fuslab-uofu/SkinCoolingDevice/FinalProduct/AssemblyFiles_Cart/Photos/VacuumOutputValve.JPG

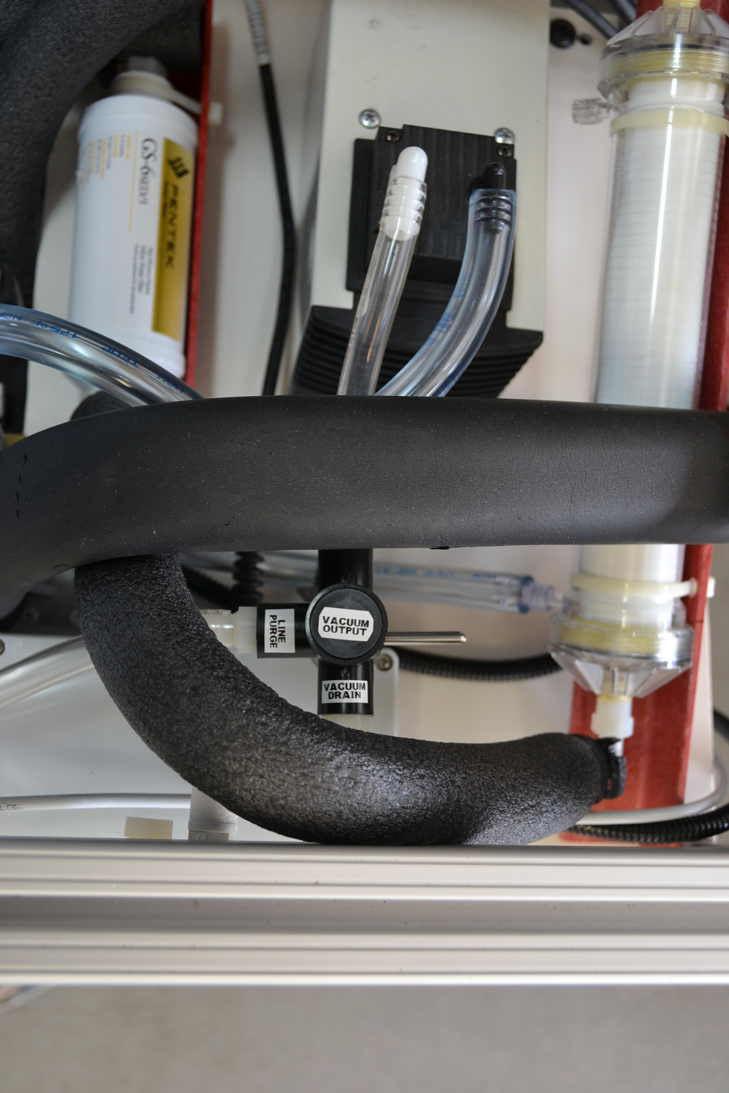
FinalProduct/AssemblyFiles_Cart/Photos/VacuumOutputValve.JPG
