fuslab-uofu/SkinCoolingDevice/FinalProduct/AssemblyFiles_Cart/Photos/Manifold_plate.JPG

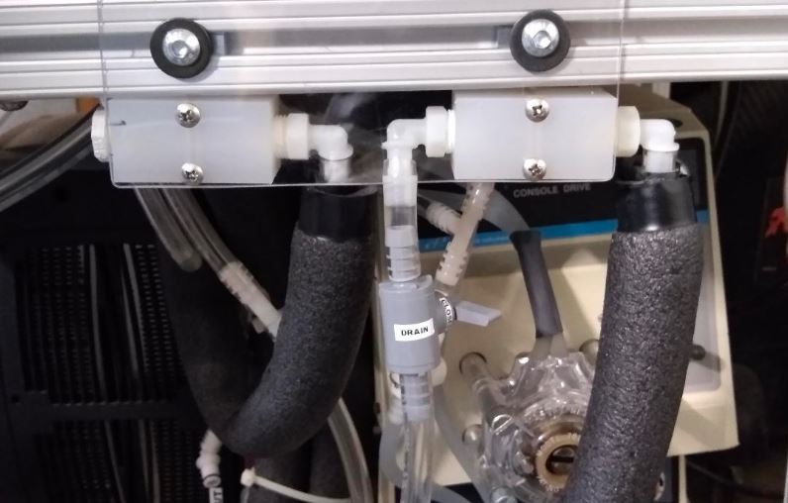
FinalProduct/AssemblyFiles_Cart/Photos/Manifold_plate.JPG
