fuslab-uofu/SkinCoolingDevice/FinalProduct/AssemblyFiles_Cart/SolidworksFiles/2019-12-03_SMB_cap_90_deg.SLDASM

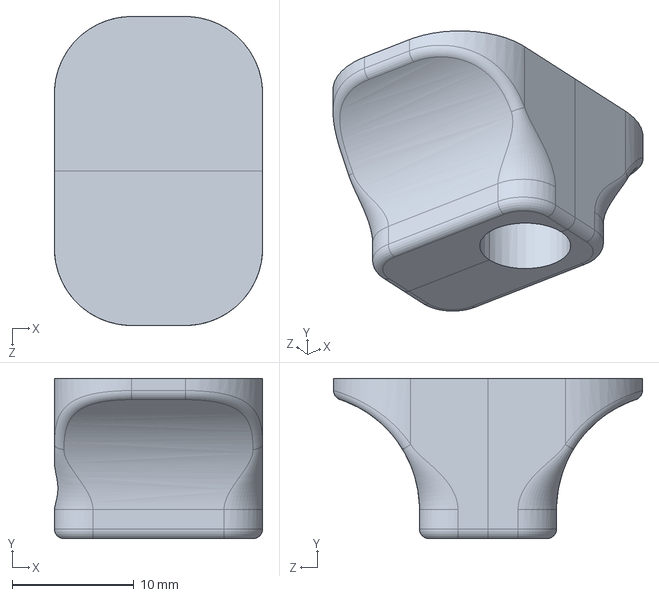
[picture p4: CAD file, 2020-09-22]
FinalProduct/AssemblyFiles_Cart/SolidworksFiles/2019-12-03_SMB_cap_90_deg.SLDASM
17.1 x 13.2 x 25.4 mm
2019-12-03 SMB cap 90 deg x 2
