fuslab-uofu/SkinCoolingDevice/FinalProduct/AssemblyFiles_Cart/SolidworksFiles/2020-01-29_pressure_gauge_mount.STL

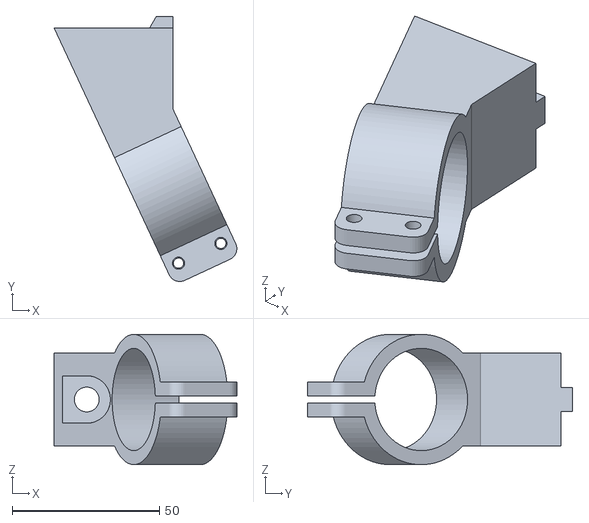
[picture p5: CAD file, 2020-09-22]
FinalProduct/AssemblyFiles_Cart/SolidworksFiles/2020-01-29_pressure_gauge_mount.STL
62.1 x 90.1 x 44.3
