fuslab-uofu/SkinCoolingDevice/FinalProduct/AssemblyFiles_Pad/2020-08-10_Large_pad_-_template.DXF

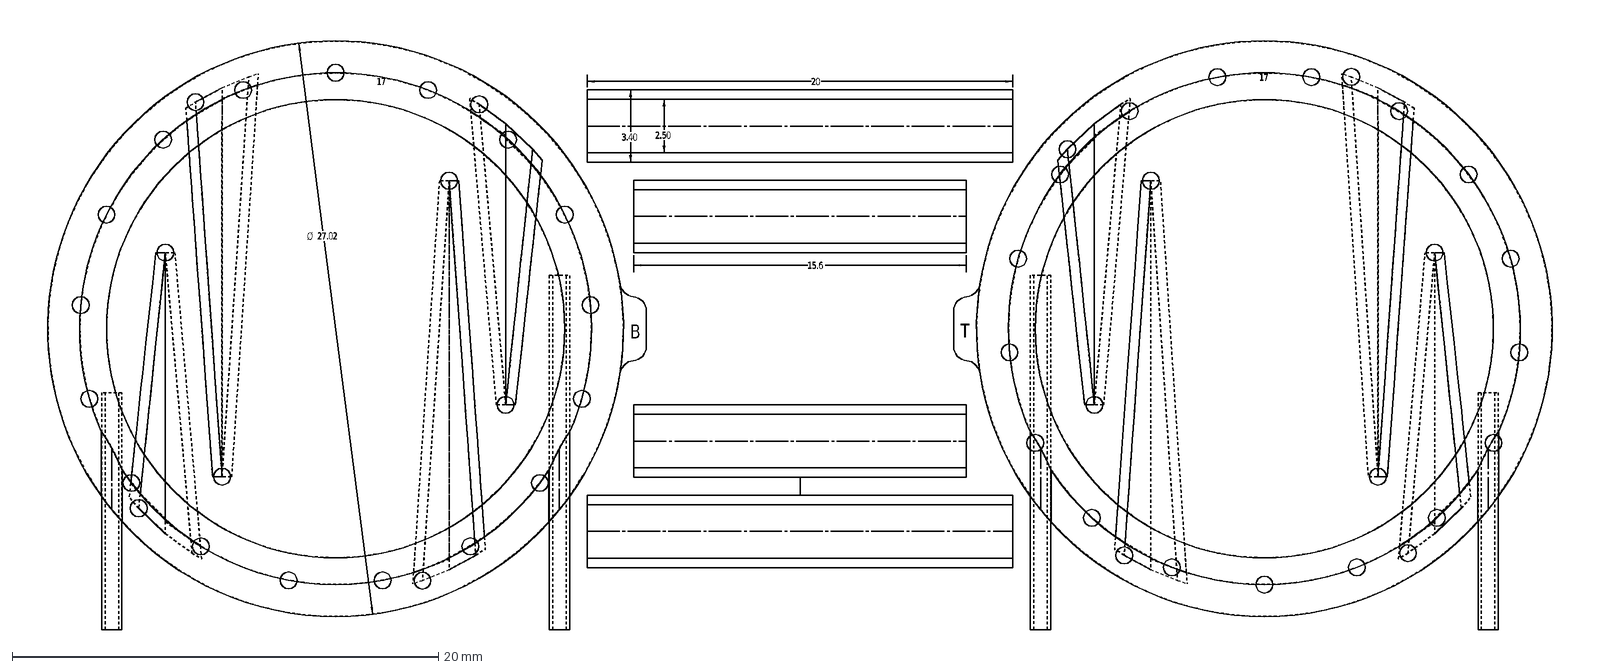
[picture p6: CAD file, 2020-09-25]
FinalProduct/AssemblyFiles_Pad/2020-08-10_Large_pad_-_template.DXF
17
15.6
20
3.40
2.50
Ø
27.02
B
T
