fuslab-uofu/SkinCoolingDevice/FinalProduct/AssemblyFiles_Cart/SolidworksFiles/2020-01-10_SMB_cap_-_straight.STL

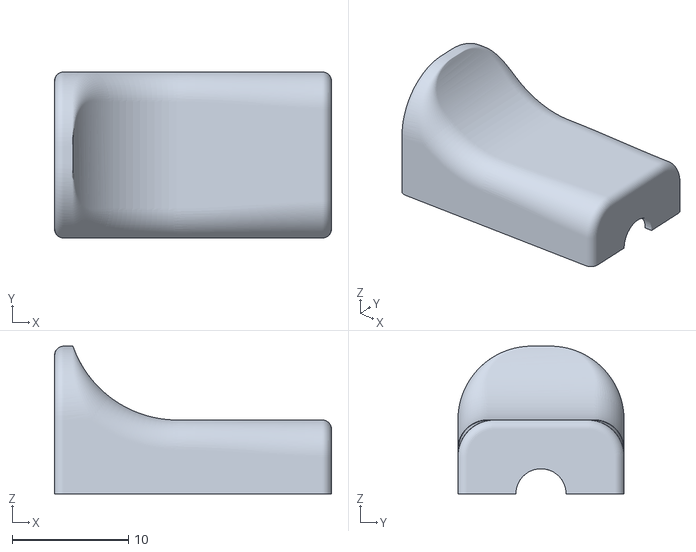
[picture p7: CAD file, 2020-09-22]
FinalProduct/AssemblyFiles_Cart/SolidworksFiles/2020-01-10_SMB_cap_-_straight.STL
23.8 x 14.3 x 12.7
