fuslab-uofu/SkinCoolingDevice/FinalProduct/AssemblyFiles_Pad/2020-08-10_Larger_Pad.SLDPRT

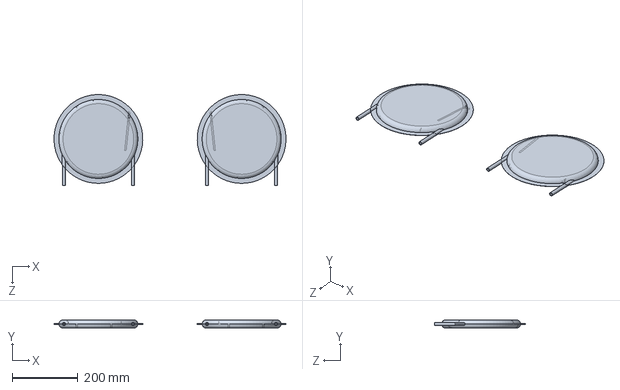
[picture p8: CAD file, 2020-09-25]
FinalProduct/AssemblyFiles_Pad/2020-08-10_Larger_Pad.SLDPRT
705.8 x 25.2 x 276.1 mm
