fuslab-uofu/SkinCoolingDevice/FinalProduct/AssemblyFiles_Cart/SolidworksFiles/2020-01-08_Joined_tubing_clamp.STL

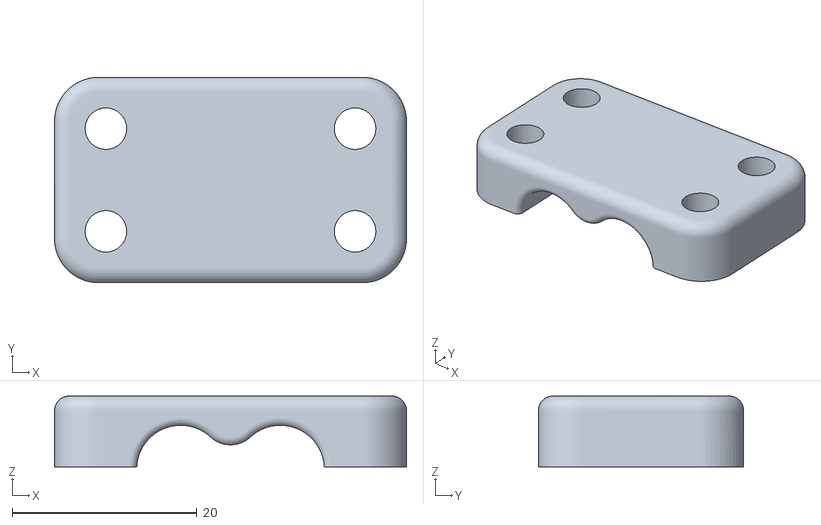
[picture p9: CAD file, 2020-09-22]
FinalProduct/AssemblyFiles_Cart/SolidworksFiles/2020-01-08_Joined_tubing_clamp.STL
38.1 x 22.2 x 7.68
