fuslab-uofu/SkinCoolingDevice/FinalProduct/AssemblyFiles_Cart/SolidworksFiles/2020-02-10_vacuum_tube_and_valve_clamp.STL

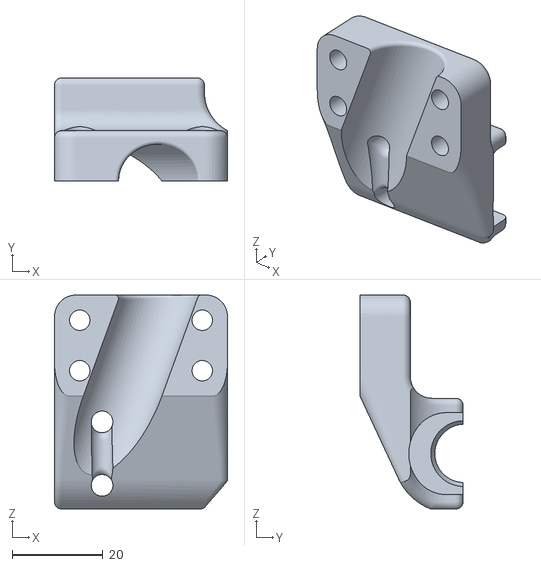
[picture p10: CAD file, 2020-09-22]
FinalProduct/AssemblyFiles_Cart/SolidworksFiles/2020-02-10_vacuum_tube_and_valve_clamp.STL
38.1 x 22.7 x 47.1
