fuslab-uofu/SkinCoolingDevice/FinalProduct/AssemblyFiles_Cart/SolidworksFiles/2020-04-22_Vacuum_muffler_angle.STL

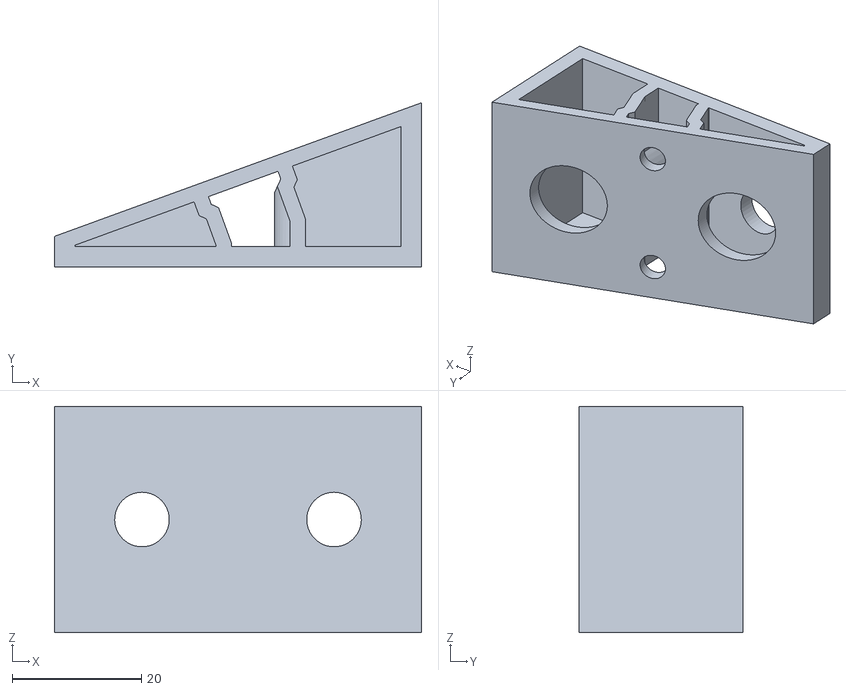
[picture p11: CAD file, 2020-09-22]
FinalProduct/AssemblyFiles_Cart/SolidworksFiles/2020-04-22_Vacuum_muffler_angle.STL
56.7 x 25.4 x 34.9
