fuslab-uofu/SkinCoolingDevice/FinalProduct/AssemblyFiles_Cart/SolidworksFiles/2020-01-23_vacuum_valve_mount.STL

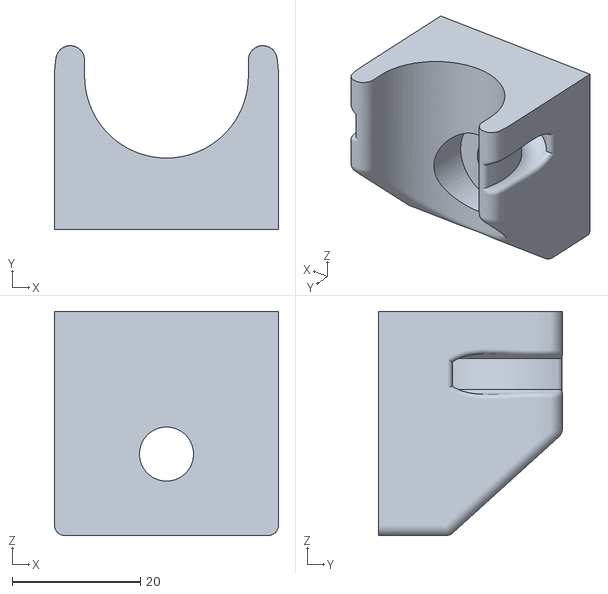
[picture p12: CAD file, 2020-09-22]
FinalProduct/AssemblyFiles_Cart/SolidworksFiles/2020-01-23_vacuum_valve_mount.STL
34.9 x 28.6 x 34.9
