fuslab-uofu/SkinCoolingDevice/FinalProduct/AssemblyFiles_Cart/SolidworksFiles/2020-02-10_vacuum_tube_and_valve_mount.STL

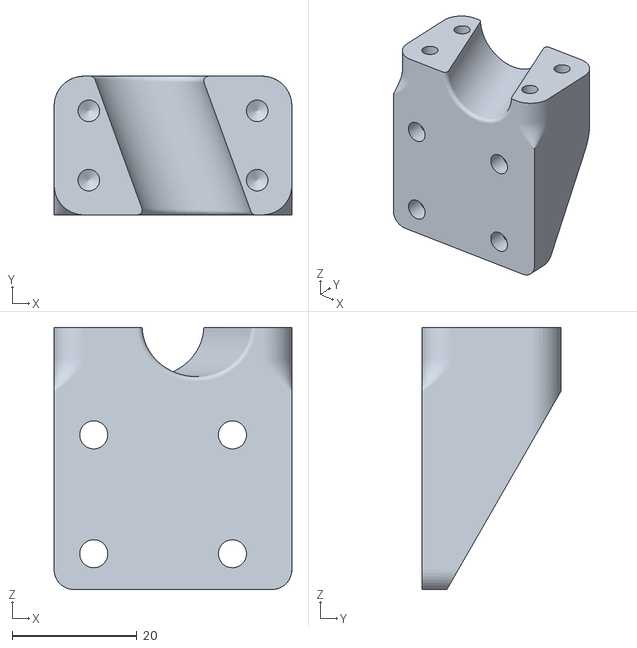
[picture p13: CAD file, 2020-09-22]
FinalProduct/AssemblyFiles_Cart/SolidworksFiles/2020-02-10_vacuum_tube_and_valve_mount.STL
38.1 x 22.2 x 42.0
