fuslab-uofu/SkinCoolingDevice/FinalProduct/AssemblyFiles_Cart/SolidworksFiles/2020-01-02_Solenoid_box_signal_feed_clamp.STL

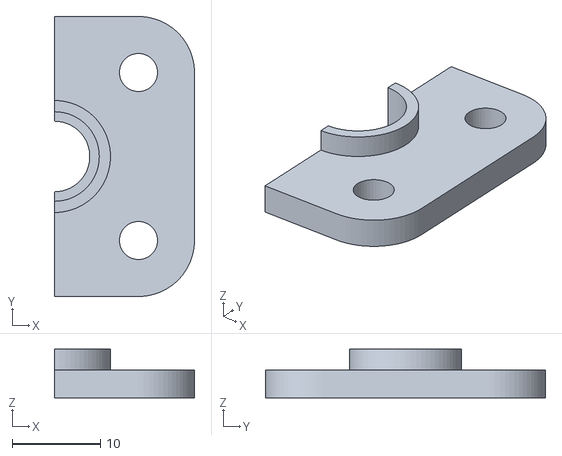
[picture p14: CAD file, 2020-09-22]
FinalProduct/AssemblyFiles_Cart/SolidworksFiles/2020-01-02_Solenoid_box_signal_feed_clamp.STL
15.9 x 31.8 x 5.54
