fuslab-uofu/SkinCoolingDevice/(list of files, cad)

Other CAD files:
FinalProduct/AssemblyFiles_Pad/2020-08-10_Pad_-_larger_size.SLDPRT
FinalProduct/AssemblyFiles_Cart/SolidworksFiles/2019-12-03_SMB_cap_90_deg.STL
FinalProduct/AssemblyFiles_Pad/2020-08-10_Large_pad_-_template.SLDDRW
