fuslab-uofu/SkinCoolingDevice/FinalProduct/AssemblyFiles_Cart/Photos/Cable_routing_lines.JPG

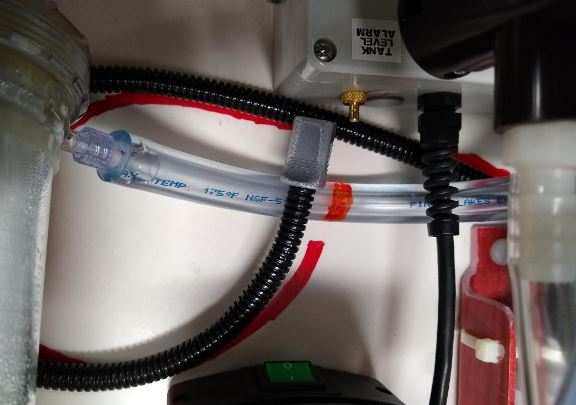
FinalProduct/AssemblyFiles_Cart/Photos/Cable_routing_lines.JPG
