fuslab-uofu/SkinCoolingDevice/FinalProduct/AssemblyFiles_Cart/Photos/Cart_collage_photo.JPG

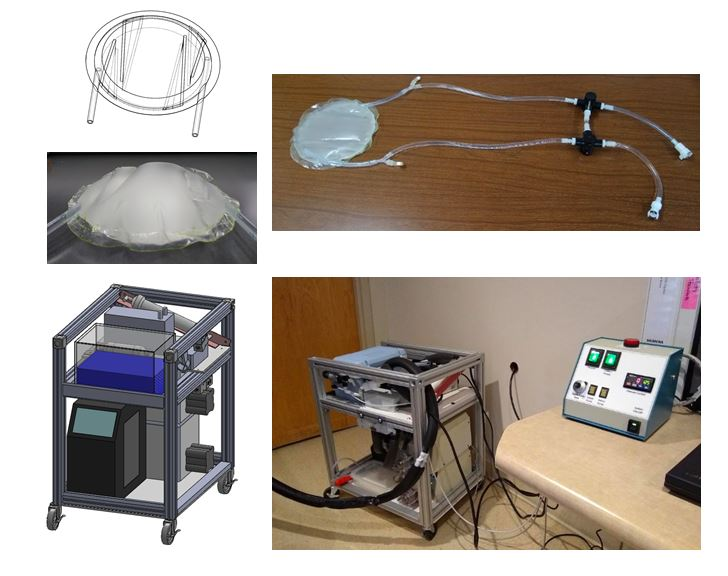
FinalProduct/AssemblyFiles_Cart/Photos/Cart_collage_photo.JPG
