fuslab-uofu/SkinCoolingDevice/FinalProduct/AssemblyFiles_Cart/Photos/Chiller_flush.jpg

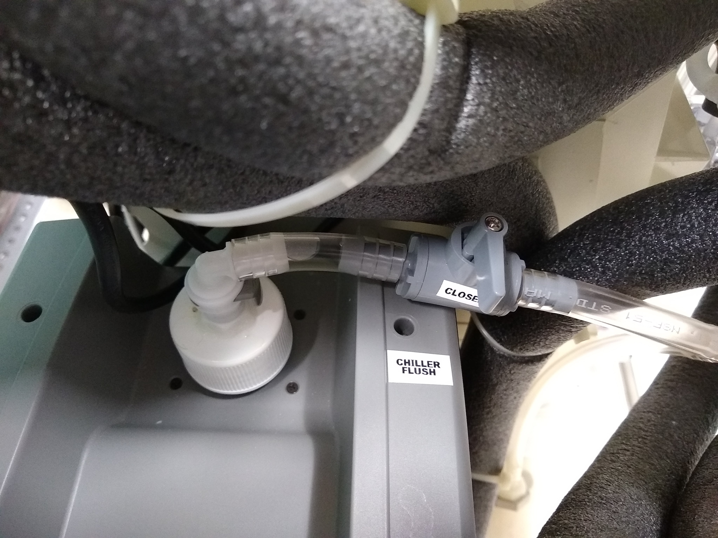
FinalProduct/AssemblyFiles_Cart/Photos/Chiller_flush.jpg
