fuslab-uofu/SkinCoolingDevice/FinalProduct/AssemblyFiles_Cart/Photos/ChillerPrimeValve.JPG

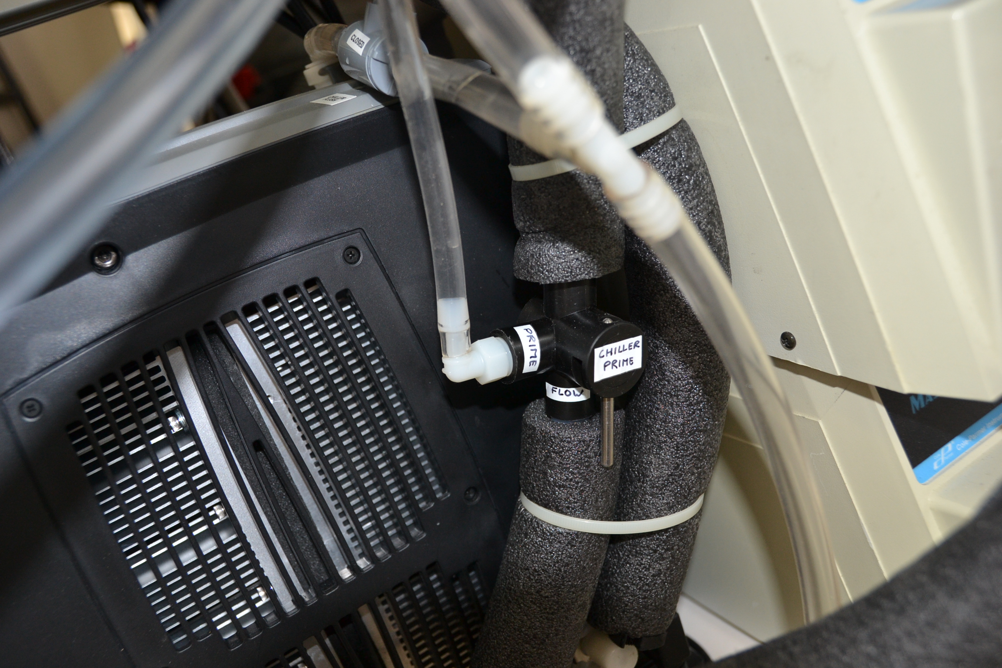
FinalProduct/AssemblyFiles_Cart/Photos/ChillerPrimeValve.JPG
