fuslab-uofu/SkinCoolingDevice/FinalProduct/AssemblyFiles_Cart/Photos/Depressurization_valve.JPG

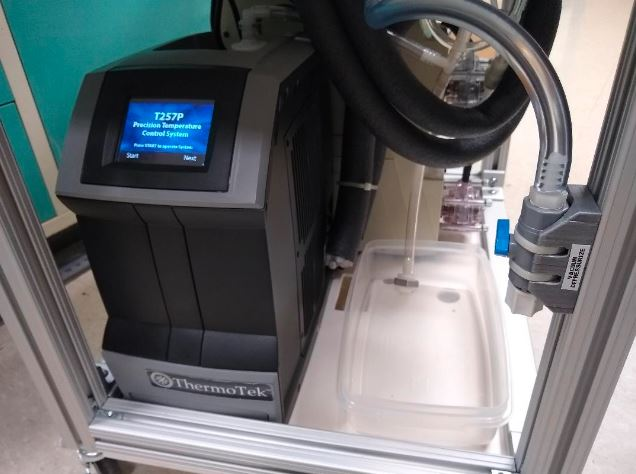
FinalProduct/AssemblyFiles_Cart/Photos/Depressurization_valve.JPG
