fuslab-uofu/SkinCoolingDevice/FinalProduct/AssemblyFiles_Cart/Photos/Drain.JPG

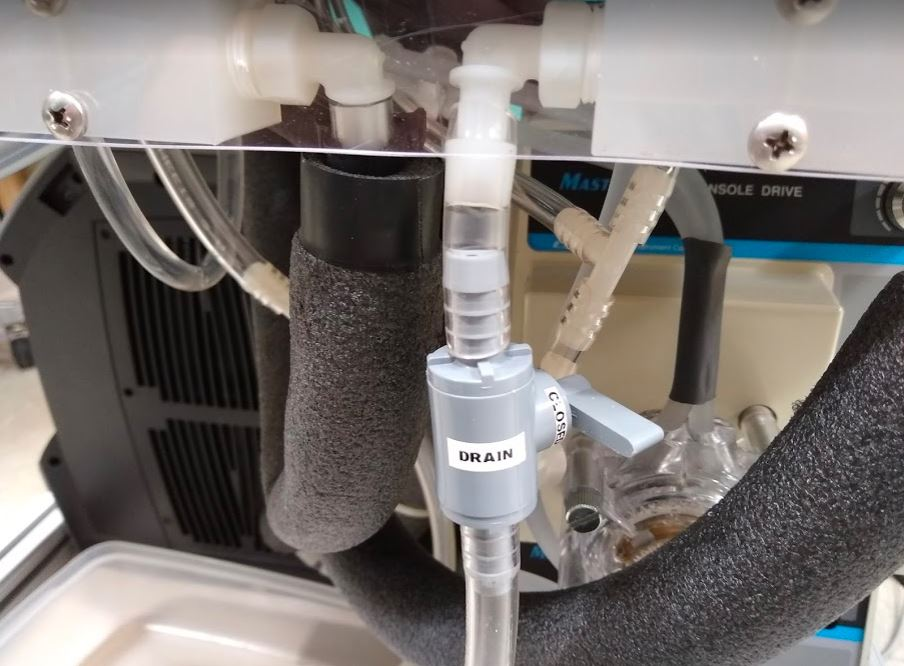
FinalProduct/AssemblyFiles_Cart/Photos/Drain.JPG
