fuslab-uofu/SkinCoolingDevice/FinalProduct/AssemblyFiles_Cart/Photos/GaugeFlushValve.JPG

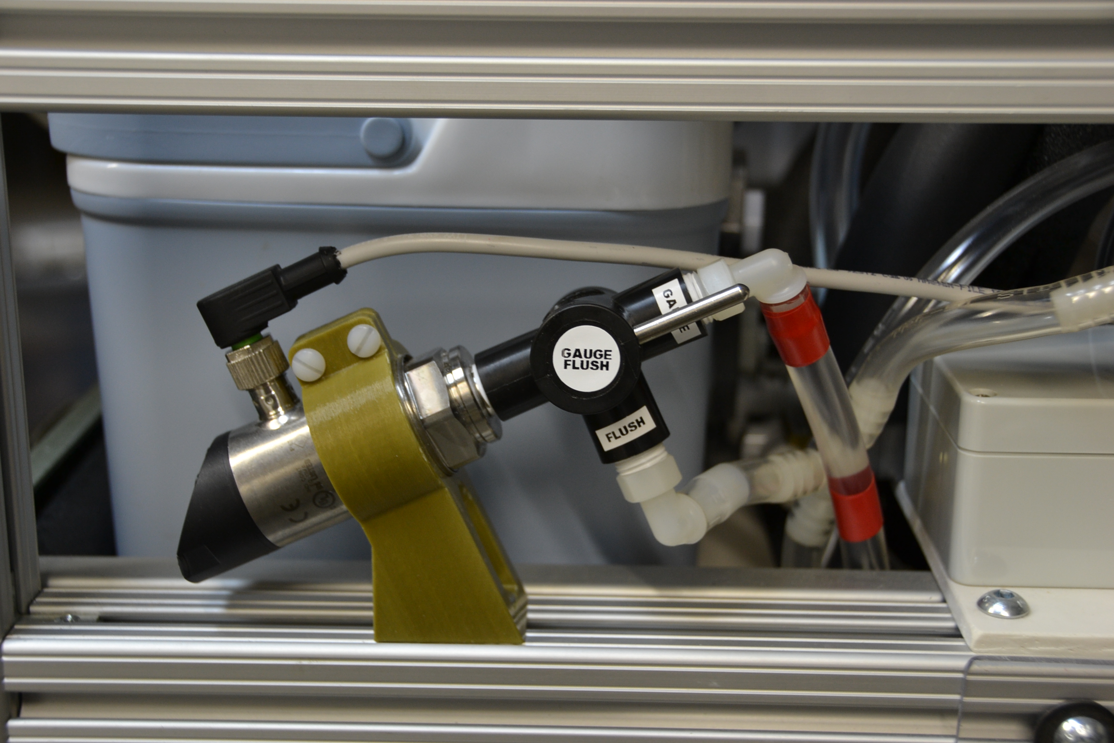
FinalProduct/AssemblyFiles_Cart/Photos/GaugeFlushValve.JPG
