fuslab-uofu/SkinCoolingDevice/FinalProduct/AssemblyFiles_Cart/Photos/Line_purge.jpg

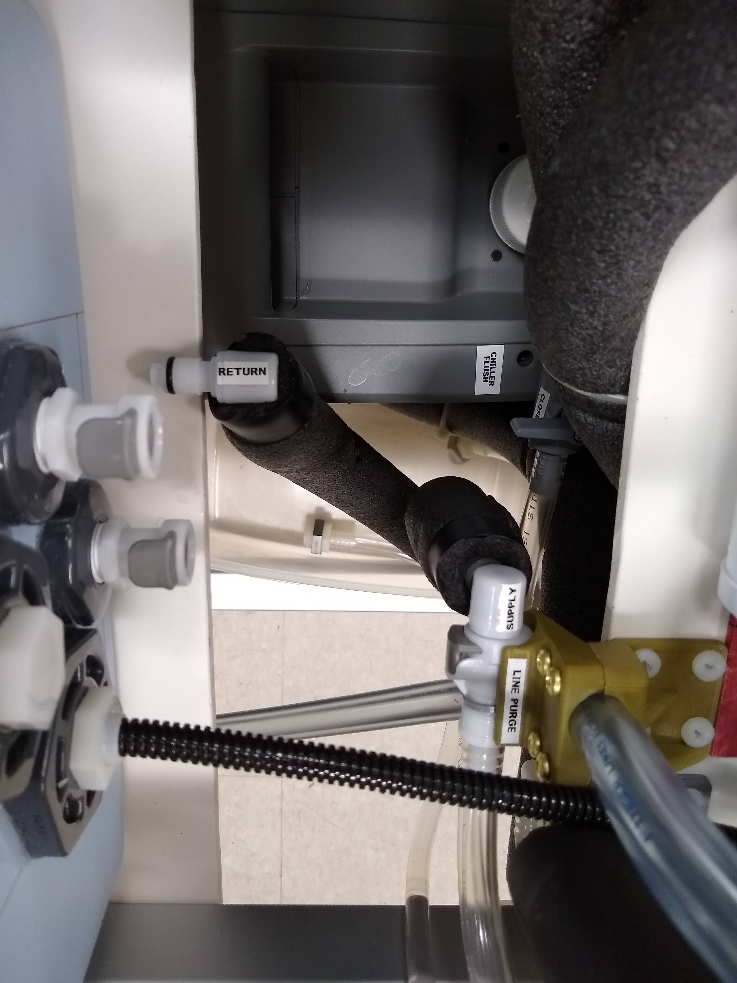
FinalProduct/AssemblyFiles_Cart/Photos/Line_purge.jpg
