fuslab-uofu/SkinCoolingDevice/FinalProduct/AssemblyFiles_Cart/Photos/Muffler.JPG

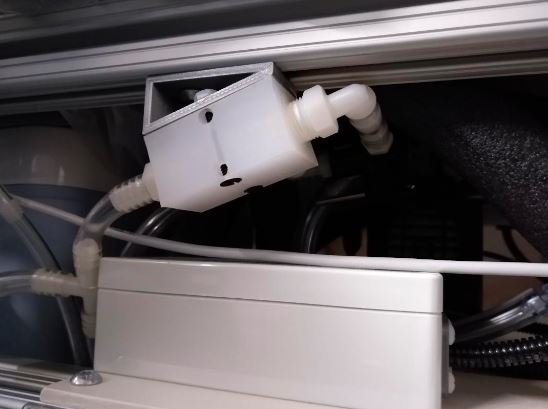
FinalProduct/AssemblyFiles_Cart/Photos/Muffler.JPG
