fuslab-uofu/SkinCoolingDevice/FinalProduct/AssemblyFiles_Cart/Photos/Pressure_gauge.jpg

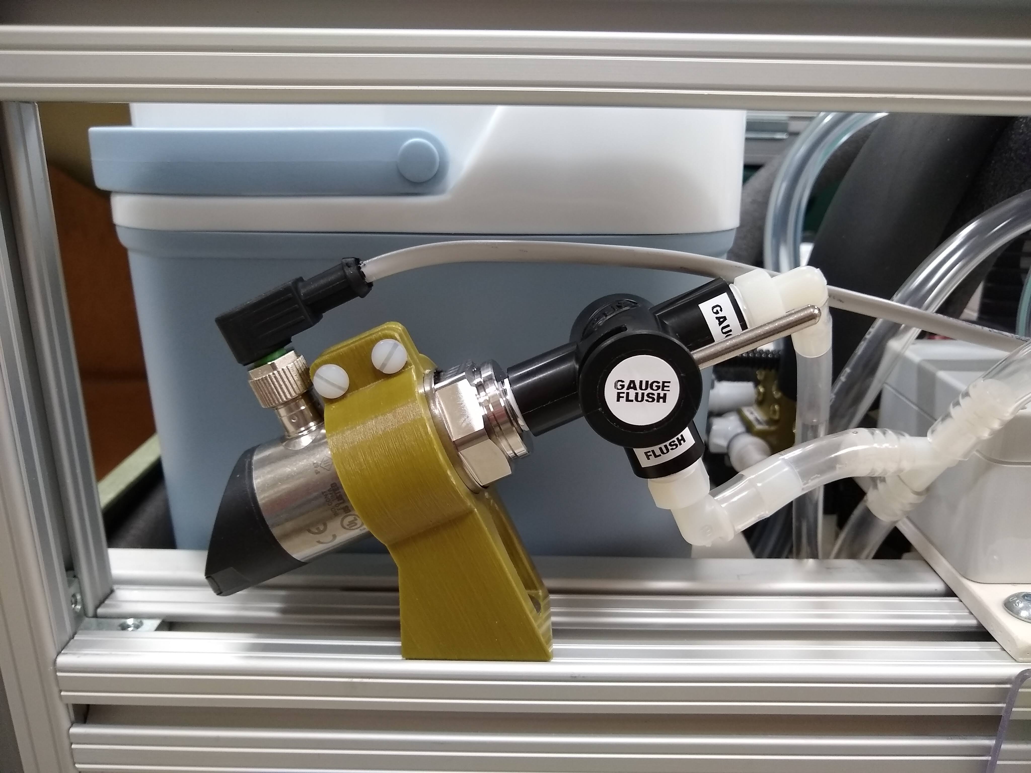
FinalProduct/AssemblyFiles_Cart/Photos/Pressure_gauge.jpg
