fuslab-uofu/SkinCoolingDevice/FinalProduct/AssemblyFiles_Cart/Photos/Reservoir_interior.JPG

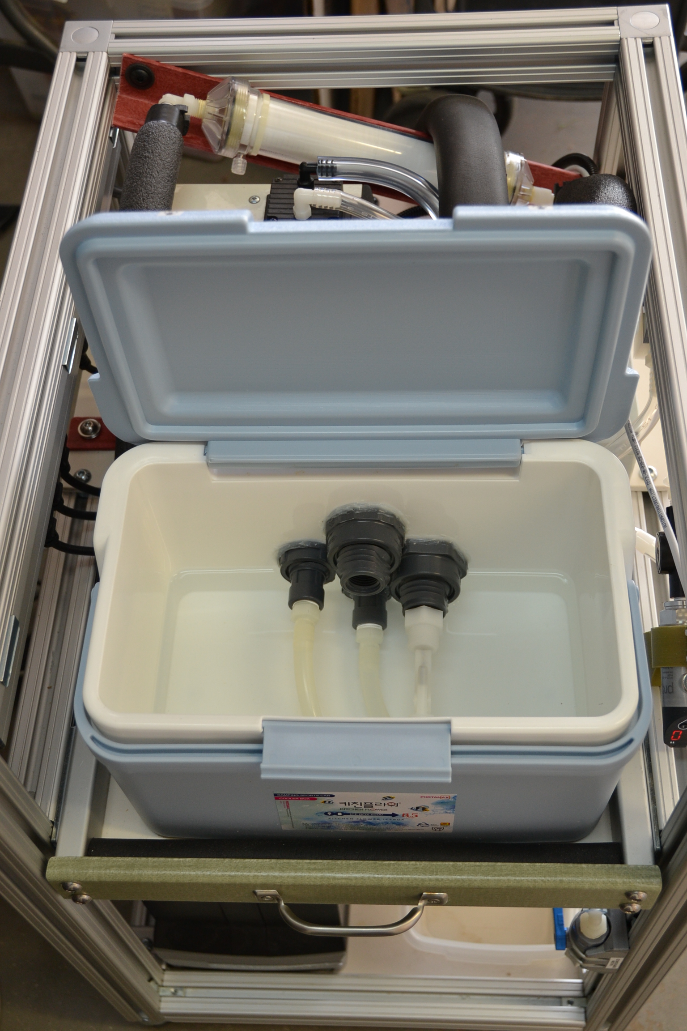
FinalProduct/AssemblyFiles_Cart/Photos/Reservoir_interior.JPG
