fuslab-uofu/SkinCoolingDevice/FinalProduct/AssemblyFiles_Cart/Photos/Reservoir_ports.jpg

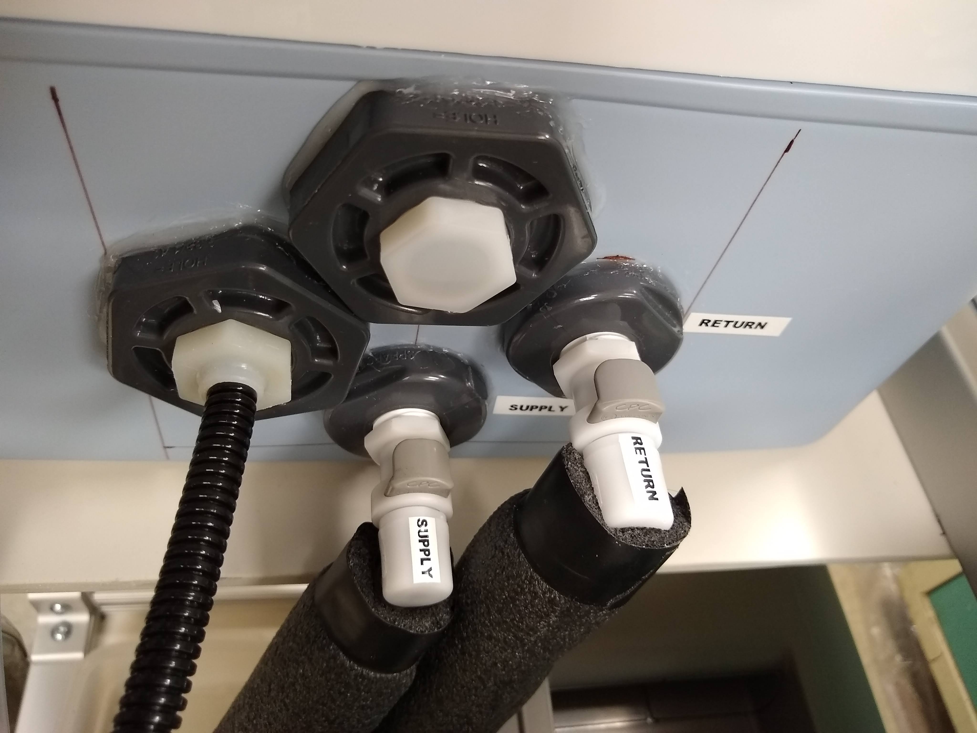
FinalProduct/AssemblyFiles_Cart/Photos/Reservoir_ports.jpg
