fuslab-uofu/SkinCoolingDevice/FinalProduct/AssemblyFiles_Cart/Photos/Vacuum_depressurization_valve.JPG

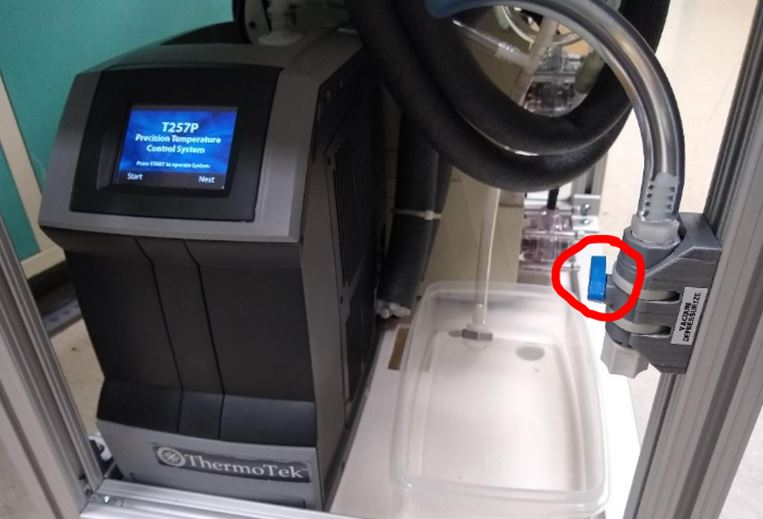
FinalProduct/AssemblyFiles_Cart/Photos/Vacuum_depressurization_valve.JPG
