fuslab-uofu/SkinCoolingDevice/FinalProduct/AssemblyFiles_Cart/Photos/Vacuum_input.JPG

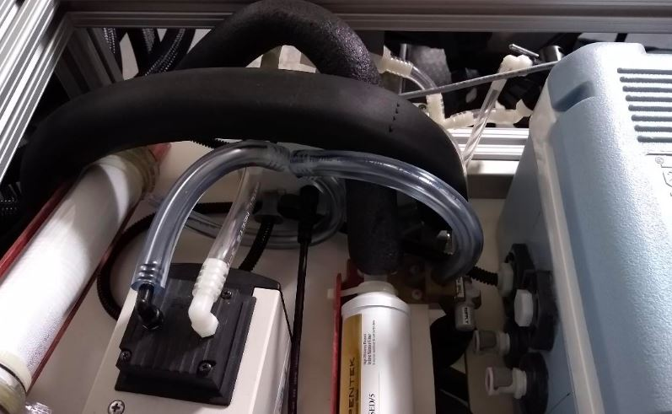
FinalProduct/AssemblyFiles_Cart/Photos/Vacuum_input.JPG
