fuslab-uofu/SkinCoolingDevice/FinalProduct/AssemblyFiles_Cart/Photos/Vacuum_input_2.JPG

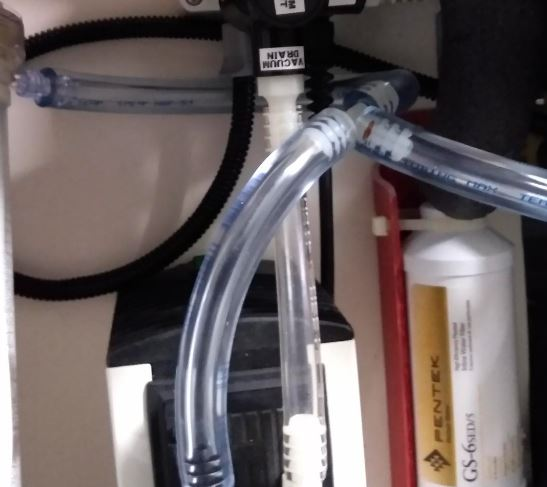
FinalProduct/AssemblyFiles_Cart/Photos/Vacuum_input_2.JPG
