fuslab-uofu/SkinCoolingDevice/FinalProduct/AssemblyFiles_Control/Photos/Control_box_backside.JPG

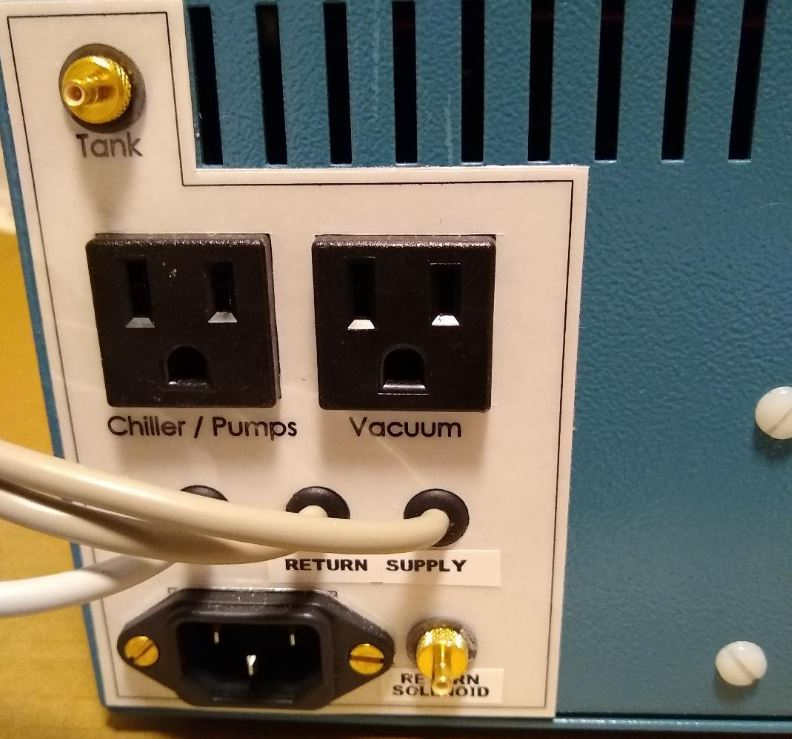
FinalProduct/AssemblyFiles_Control/Photos/Control_box_backside.JPG
