fuslab-uofu/SkinCoolingDevice/FinalProduct/AssemblyFiles_Control/Photos/Control_box_front.JPG

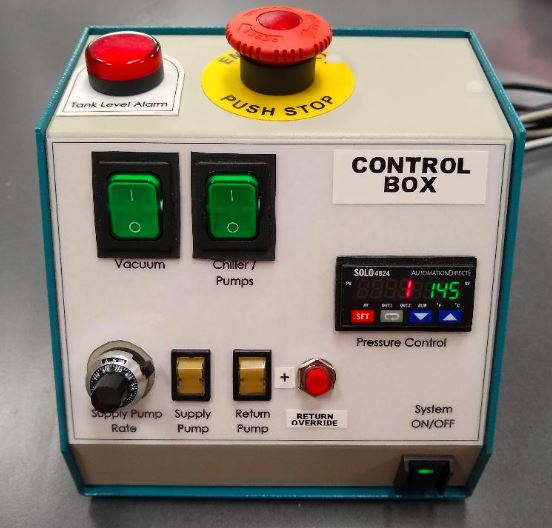
FinalProduct/AssemblyFiles_Control/Photos/Control_box_front.JPG
