fuslab-uofu/SkinCoolingDevice/FinalProduct/AssemblyFiles_Pad/MFG_diagram.JPG

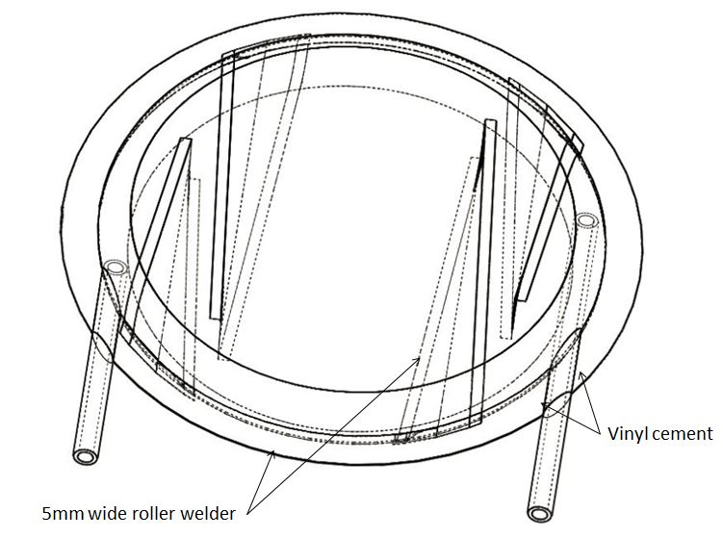
FinalProduct/AssemblyFiles_Pad/MFG_diagram.JPG
