fuslab-uofu/SkinCoolingDevice/FinalProduct/AssemblyFiles_Pad/Skin_cooling_pad_illustration.JPG

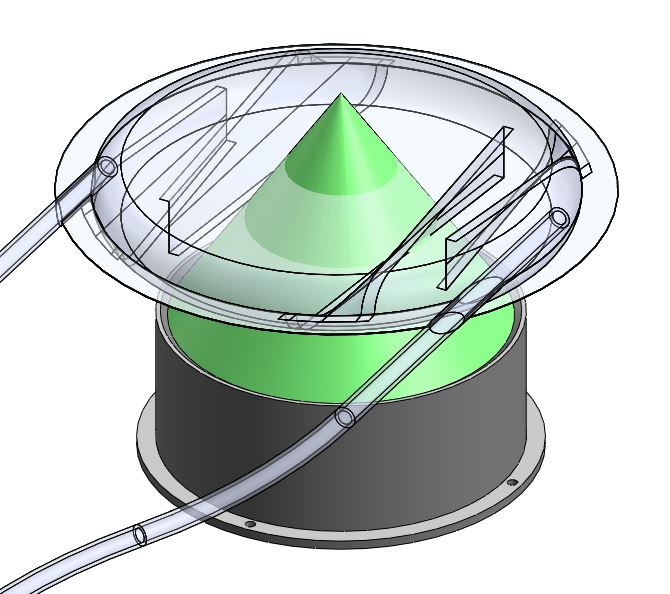
FinalProduct/AssemblyFiles_Pad/Skin_cooling_pad_illustration.JPG
