fuslab-uofu/SkinCoolingDevice/FinalProduct/AssemblyFiles_Pad/Skin_cooling_pad_picture_msmt.jpg

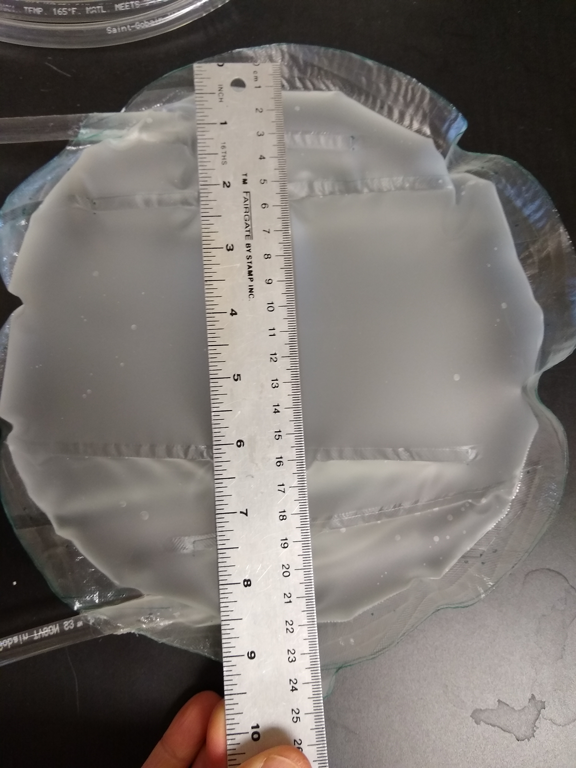
FinalProduct/AssemblyFiles_Pad/Skin_cooling_pad_picture_msmt.jpg
