fuslab-uofu/SkinCoolingDevice/FinalProduct/AssemblyFiles_Plumbing/2021-02-16 Plumbing Diagram.pdf

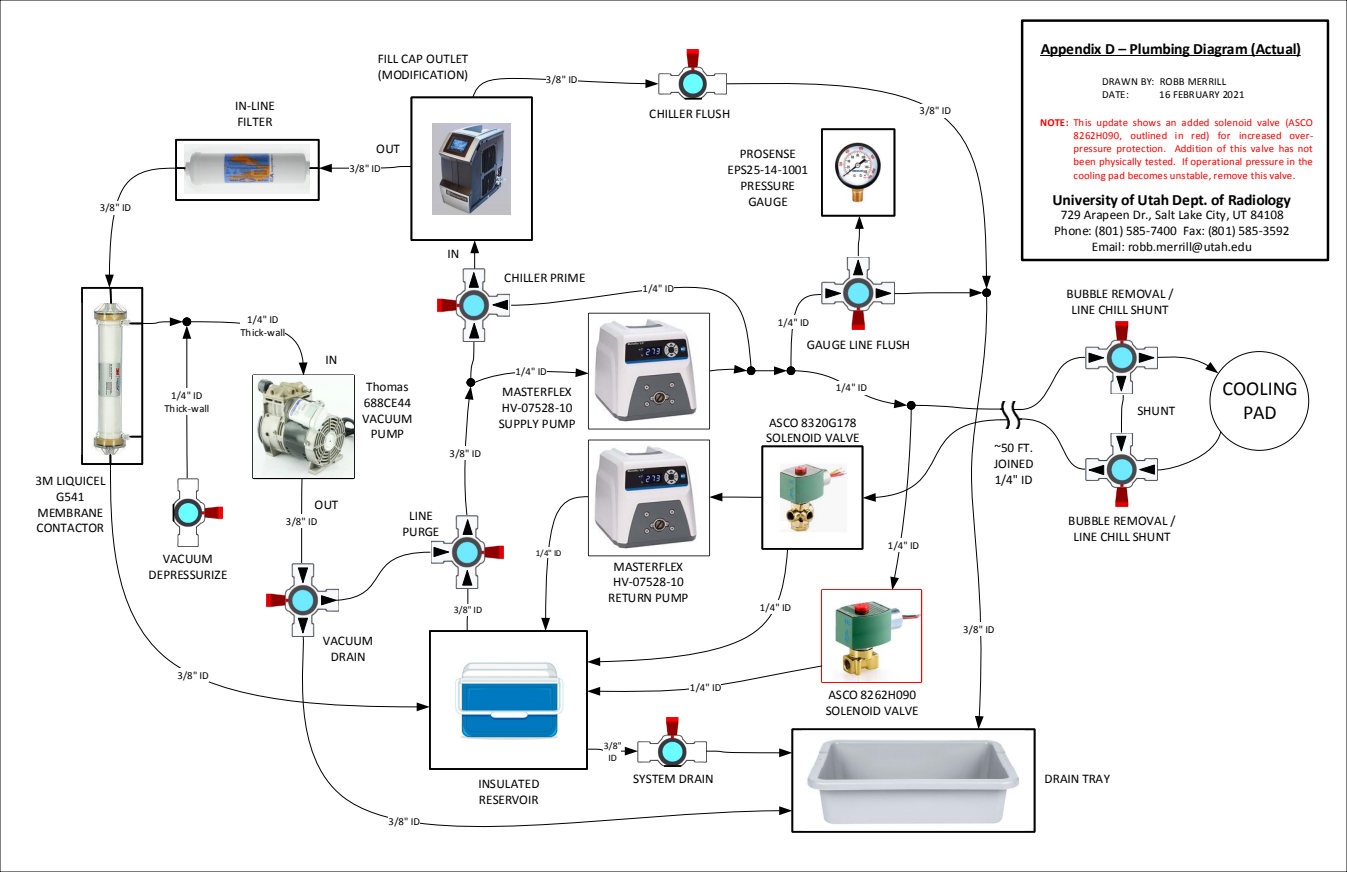
[picture p59: page 1]
DATE:; 16 FEBRUARY 2021; 1/4" ID Thick-wall; COOLING PAD; OUT; VACUUM DEPRESSURIZE; VACUUM DRAIN; LINE PURGE; IN-LINE FILTER; 3M LIQUICEL G541 MEMBRANE CONTACTOR; MASTERFLEX HV-07528-10 SUPPLY PUMP; MASTERFLEX HV-07528-10 RETURN PUMP; INSULATED RESERVOIR; DRAIN TRAY; ~50 FT. JOINED 1/4" ID; SHUNT; PROSENSE EPS25-14-1001 PRESSURE GAUGE; SYSTEM DRAIN; Thomas 688CE44 VACUUM PUMP; CHILLER FLUSH; ASCO 8320G178 SOLENOID VALVE; CHILLER PRIME; ASCO 8262H090 SOLENOID VALVE

Appendix D – Plumbing Diagram (Actual)

FILL CAP OUTLET
(MODIFICATION)

DRAWN BY: ROBB MERRILL

NOTE: This update shows an added solenoid valve (ASCO

8262H090, outlined in red) for increased over-
pressure protection. Addition of this valve has not
been physically tested. If operational pressure in the
cooling pad becomes unstable, remove this valve.
University of Utah Dept. of Radiology
729 Arapeen Dr., Salt Lake City, UT 84108
Phone: (801) 585-7400 Fax: (801) 585-3592
Email: robb.merrill@utah.edu

BUBBLE REMOVAL /
LINE CHILL SHUNT

GAUGE LINE FLUSH
