fuslab-uofu/SkinCoolingDevice/FinalProduct/AssemblyFiles_Control/WiringDiagram/2021-02-16 Control Box Wiring Diagram.pdf

## 729 Arapeen Dr., Salt Lake City, UT 84108 Phone: (801) 585-7400 Fax: (801) 585-3592

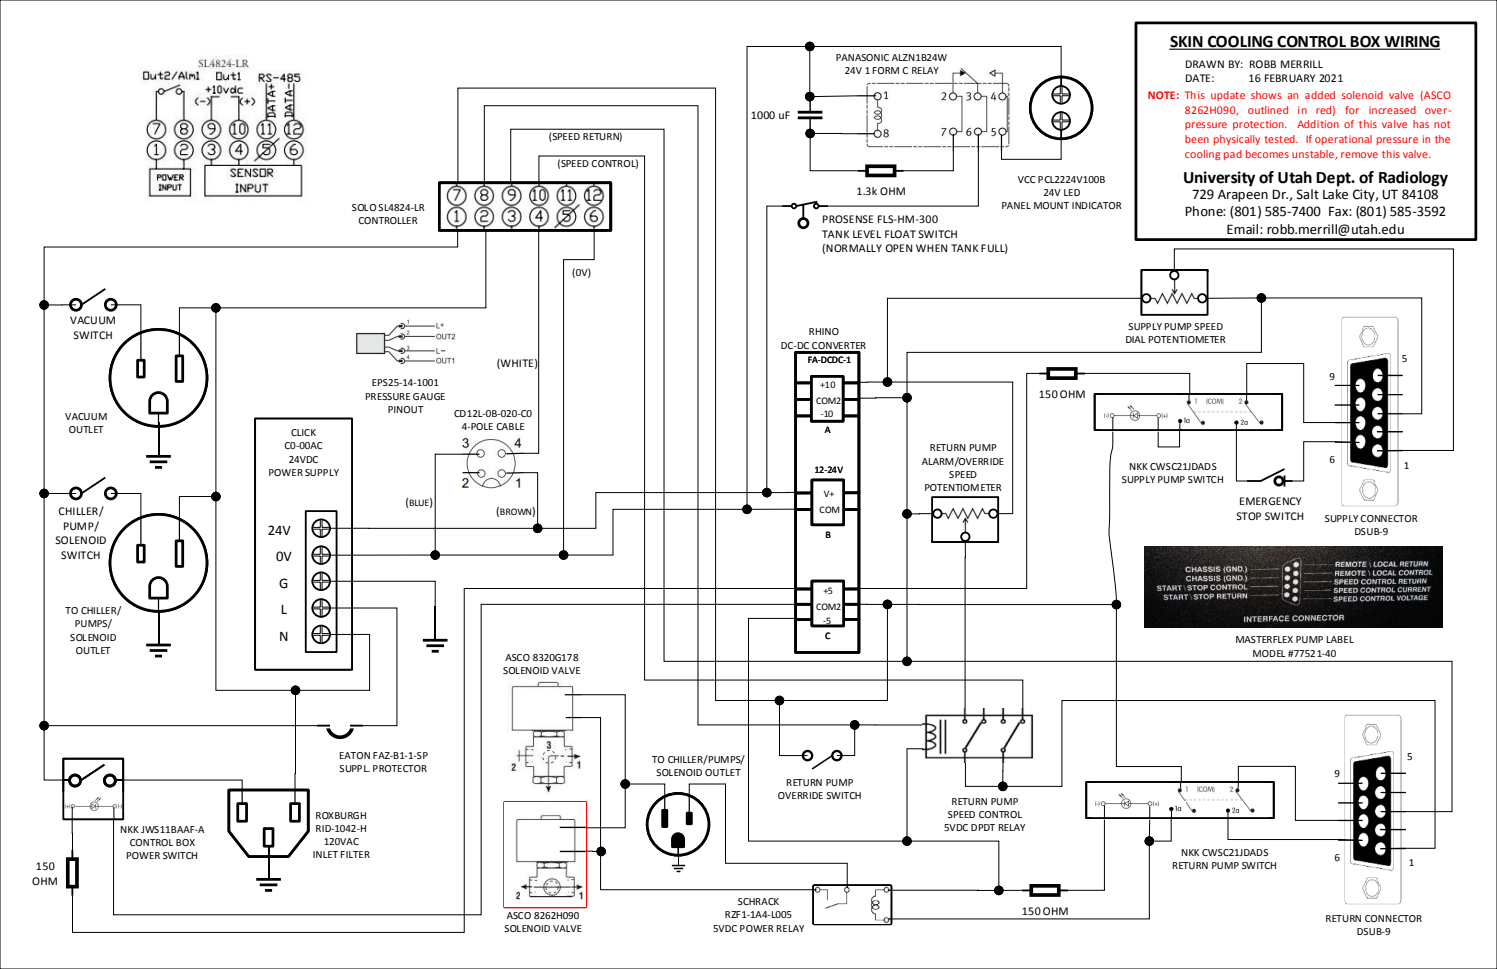
[picture p60: page 1]
CHILLER/ PUMP/ SOLENOID SWITCH; VACUUM SWITCH; COM2 -5; COM2 -10; COM; FA-DCDC-1; 150 OHM; 1.3k OHM; SUPPLY CONNECTOR DSUB-9; RETURN CONNECTOR DSUB-9; ASCO 8320G178 SOLENOID VALVE; ROXBURGH RID-1042-H 120VAC INLET FILTER; NKK JWS11BAAF-A CONTROL BOX POWER SWITCH; CLICK C0-00AC 24VDC POWER SUPPLY; SOLO SL4824-LR CONTROLLER; SCHRACK RZF1-1A4-L005 5VDC POWER RELAY; EPS25-14-1001 PRESSURE GAUGE; PINOUT; 4-POLE CABLE; VCC PCL2224V100B 24V LED; PANASONIC ALZN1B24W 24V 1 FORM C RELAY; (BROWN); (BLUE)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

SKIN COOLING CONTROL BOX WIRING

DRAWN BY: ROBB MERRILL

NOTE: This update shows an added solenoid valve (ASCO

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

PANEL MOUNT INDICATOR

PROSENSE FLS-HM-300
TANK LEVEL FLOAT SWITCH
(NORMALLY OPEN WHEN TANK FULL)

Email: robb.merrill@utah.edu

RHINO
DC-DC CONVERTER
FA-DCDC-1

SUPPLY PUMP SPEED
DIAL POTENTIOMETER

NKK CWSC21JDADS
SUPPLY PUMP SWITCH

MASTERFLEX PUMP LABEL
MODEL #77521-40

EATON FAZ-B1-1-SP
SUPPL. PROTECTOR

TO CHILLER/PUMPS/
SOLENOID OUTLET

RETURN PUMP SWITCH
