fuslab-uofu/SkinCoolingDevice/FinalProduct/AssemblyFiles_Cart/AssemblyDiagrams/2020-08-25_PPM_probe_Asm.PDF

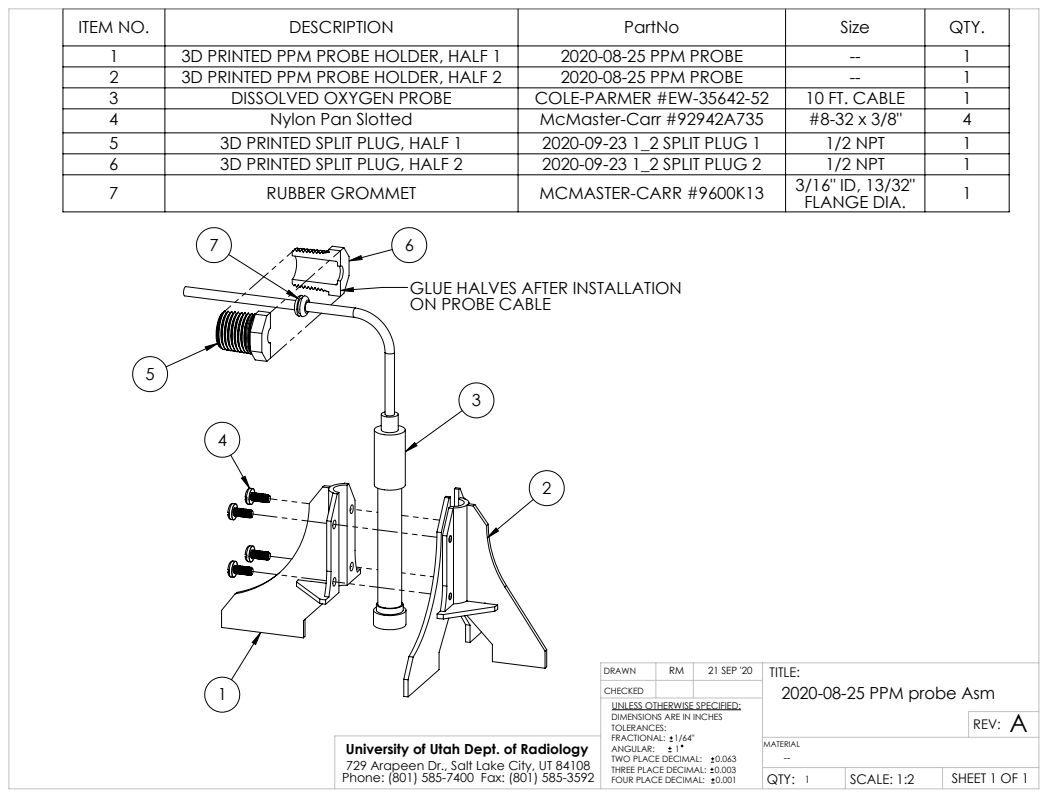
[picture p61: page 1]

ITEM NO. | DESCRIPTION | PartNo | Size | QTY.
1 | 3D PRINTED PPM PROBE HOLDER, HALF 1 | 2020-08-25 PPM PROBE | -- | 1
2 | 3D PRINTED PPM PROBE HOLDER, HALF 2 | 2020-08-25 PPM PROBE | -- | 1
3 | DISSOLVED OXYGEN PROBE | COLE-PARMER #EW-35642-52 | 10 FT. CABLE | 1
4 | Nylon Pan Slotted | McMaster-Carr #92942A735 | #8-32 x 3/8" | 4
5 | 3D PRINTED SPLIT PLUG, HALF 1 | 2020-09-23 1_2 SPLIT PLUG 1 | 1/2 NPT | 1
6 | 3D PRINTED SPLIT PLUG, HALF 2 | 2020-09-23 1_2 SPLIT PLUG 2 | 1/2 NPT | 1
7 | RUBBER GROMMET | MCMASTER-CARR #9600K13 | 3/16" ID, 13/32" FLANGE DIA. | 1

GLUE HALVES AFTER INSTALLATION
ON PROBE CABLE

DRAWN | RM | 21 SEP '20 | TITLE: 2020-08-25 PPM probe Asm
CHECKED

UNLESS OTHERWISE SPECIFIED:
A DIMENSIONS ARE IN INCHES
TOLERANCES:
FRACTIONAL: 1/64"
TWO PLACE DECIMAL: 0.063
THREE PLACE DECIMAL: 0.003
FOUR PLACE DECIMAL: 0.001

University of Utah Dept. of Radiology 729 Arapeen Dr., Salt Lake City, UT 84108 Phone: (801) 585-7400 Fax: (801) 585-3592 | | MATERIAL --

QTY: 1 | SCALE: 1:2 | SHEET 1 OF 1
