fuslab-uofu/SkinCoolingDevice/FinalProduct/AssemblyFiles_Cart/AssemblyDiagrams/2020-09-23_Tank_Asm.PDF

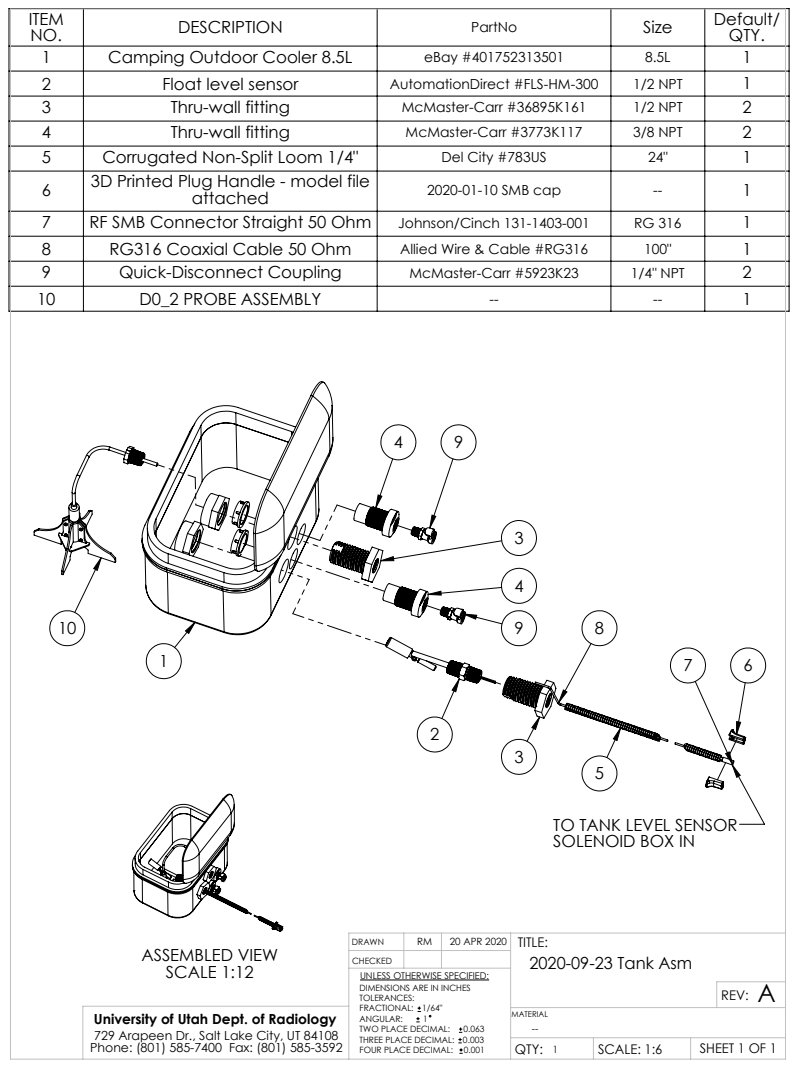
[picture p62: page 1]
ASSEMBLED VIEW SCALE 1:12

ITEM NO. | DESCRIPTION | PartNo | Size | Default/ QTY.
1 | Camping Outdoor Cooler 8.5L | eBay #401752313501 | 8.5L | 1
2 | Float level sensor | AutomationDirect #FLS-HM-300 | 1/2 NPT | 1
3 | Thru-wall fitting | McMaster-Carr #36895K161 | 1/2 NPT | 2
4 | Thru-wall fitting | McMaster-Carr #3773K117 | 3/8 NPT | 2
5 | Corrugated Non-Split Loom 1/4" | Del City #783US | 24" | 1
6 | 3D Printed Plug Handle - model file attached | 2020-01-10 SMB cap | -- | 1

7 | RF SMB Connector Straight 50 Ohm | Johnson/Cinch 131-1403-001 | RG 316 | 1
8 | RG316 Coaxial Cable 50 Ohm | Allied Wire & Cable #RG316 | 100" | 1
9 | Quick-Disconnect Coupling | McMaster-Carr #5923K23 | 1/4" NPT | 2
10 | D0_2 PROBE ASSEMBLY | -- | -- | 1

TO TANK LEVEL SENSOR
SOLENOID BOX IN

DRAWN | RM | 20 APR 2020 | TITLE: 2020-09-23 Tank Asm
CHECKED

UNLESS OTHERWISE SPECIFIED:
DIMENSIONS ARE IN INCHES
TOLERANCES:
FRACTIONAL: 1/64"
TWO PLACE DECIMAL: 0.063
THREE PLACE DECIMAL: 0.003
FOUR PLACE DECIMAL: 0.001

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

QTY: 1 | SCALE: 1:6 | SHEET 1 OF 1
