fuslab-uofu/SkinCoolingDevice/FinalProduct/AssemblyFiles_Cart/AssemblyDiagrams/2019-10-08_Reservoir_Asm.PDF

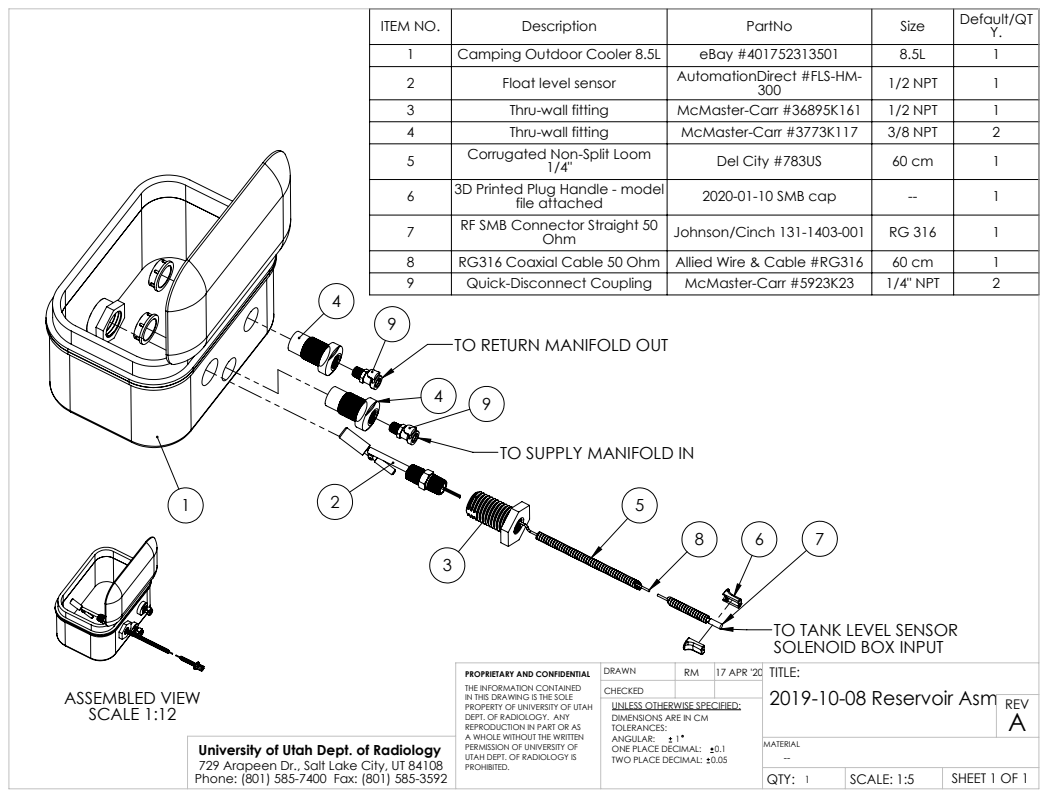
[picture p64: page 1]
TO RETURN MANIFOLD OUT; ASSEMBLED VIEW SCALE 1:12

ITEM NO. | Description | PartNo | Size | Default/QT Y.

1 | Camping Outdoor Cooler 8.5L | eBay #401752313501 | 8.5L | 1
2 | Float level sensor | AutomationDirect #FLS-HM-300 | 1/2 NPT | 1
3 | Thru-wall fitting | McMaster-Carr #36895K161 | 1/2 NPT | 1
4 | Thru-wall fitting | McMaster-Carr #3773K117 | 3/8 NPT | 2
5 | Corrugated Non-Split Loom 1/4" | Del City #783US | 60 cm | 1

6 | 3D Printed Plug Handle - model file attached | 2020-01-10 SMB cap | -- | 1

7 | RF SMB Connector Straight 50 Ohm | Johnson/Cinch 131-1403-001 | RG 316 | 1

8 | RG316 Coaxial Cable 50 Ohm | Allied Wire & Cable #RG316 | 60 cm | 1
9 | Quick-Disconnect Coupling | McMaster-Carr #5923K23 | 1/4" NPT | 2

TO SUPPLY MANIFOLD IN

TO TANK LEVEL SENSOR
SOLENOID BOX INPUT
2019-10-08 Reservoir Asm

PROPRIETARY AND CONFIDENTIAL THE INFORMATION CONTAINED IN THIS DRAWING IS THE SOLE PROPERTY OF UNIVERSITY OF UTAH DEPT. OF RADIOLOGY. ANY REPRODUCTION IN PART OR AS A WHOLE WITHOUT THE WRITTEN PERMISSION OF UNIVERSITY OF UTAH DEPT. OF RADIOLOGY IS PROHIBITED. | DRAWN | RM | 17 APR '20 | TITLE:

CHECKED

UNLESS OTHERWISE SPECIFIED:
A DIMENSIONS ARE IN CM
TOLERANCES:
ONE PLACE DECIMAL: 0.1
TWO PLACE DECIMAL: 0.05

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

QTY: 1 | SCALE: 1:5 | SHEET 1 OF 1
