fuslab-uofu/SkinCoolingDevice/FinalProduct/AssemblyFiles_Cart/AssemblyDiagrams/2020-01-10_Filter_Asm.PDF

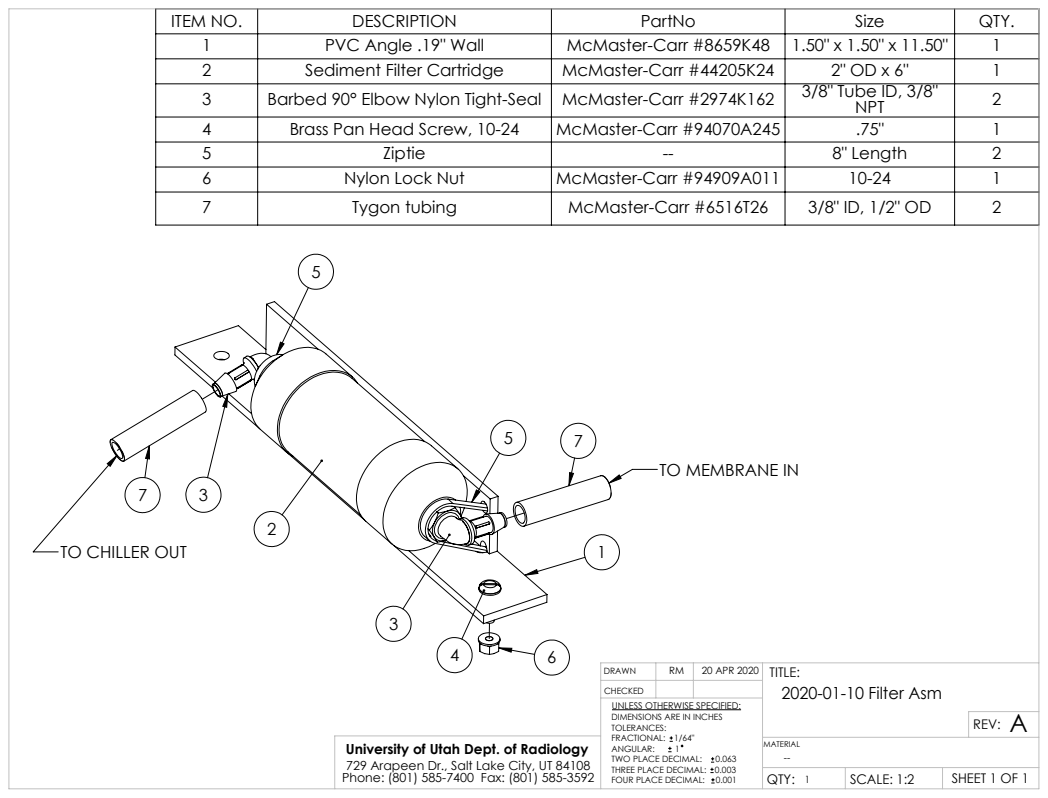
[picture p66: page 1]

ITEM NO. | DESCRIPTION | PartNo | Size | QTY.
1 | PVC Angle .19" Wall | McMaster-Carr #8659K48 | 1.50" x 1.50" x 11.50" | 1
2 | Sediment Filter Cartridge | McMaster-Carr #44205K24 | 2" OD x 6" | 1
3 | Barbed 90° Elbow Nylon Tight-Seal | McMaster-Carr #2974K162 | 3/8" Tube ID, 3/8" NPT | 2
4 | Brass Pan Head Screw, 10-24 | McMaster-Carr #94070A245 | .75" | 1
5 | Ziptie | -- | 8" Length | 2
6 | Nylon Lock Nut | McMaster-Carr #94909A011 | 10-24 | 1
7 | Tygon tubing | McMaster-Carr #6516T26 | 3/8" ID, 1/2" OD | 2

TO MEMBRANE IN

TO CHILLER OUT

DRAWN | RM | 20 APR 2020 | TITLE: 2020-01-10 Filter Asm
CHECKED

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

QTY: 1 | SCALE: 1:2 | SHEET 1 OF 1
