fuslab-uofu/SkinCoolingDevice/FinalProduct/AssemblyFiles_Cart/AssemblyDiagrams/2020-04-20_Cooling_cart_Asm.PDF

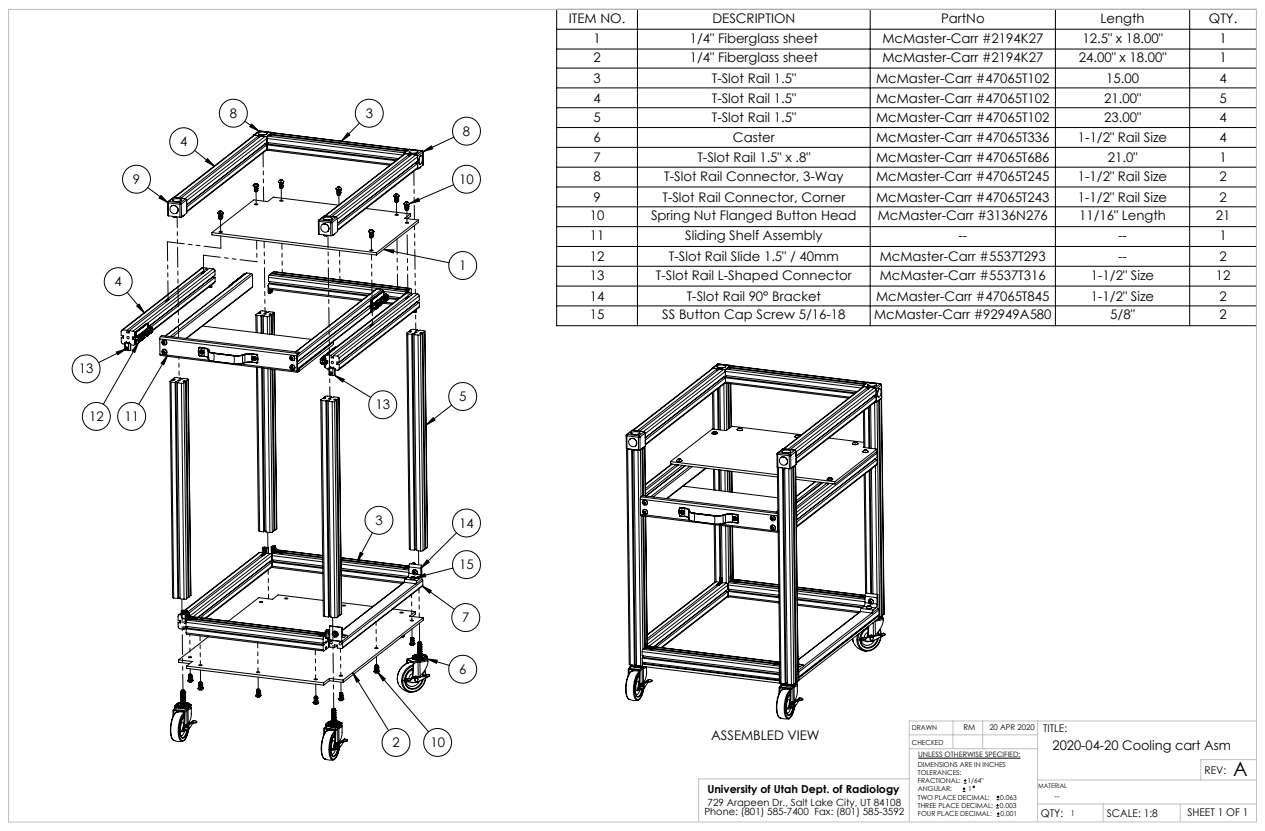
[picture p67: page 1]
ASSEMBLED VIEW

ITEM NO. | DESCRIPTION | PartNo | Length | QTY.
1 | 1/4" Fiberglass sheet | McMaster-Carr #2194K27 | 12.5" x 18.00" | 1
2 | 1/4" Fiberglass sheet | McMaster-Carr #2194K27 | 24.00" x 18.00" | 1
3 | T-Slot Rail 1.5" | McMaster-Carr #47065T102 | 15.00 | 4
4 | T-Slot Rail 1.5" | McMaster-Carr #47065T102 | 21.00" | 5
5 | T-Slot Rail 1.5" | McMaster-Carr #47065T102 | 23.00" | 4
6 | Caster | McMaster-Carr #47065T336 | 1-1/2" Rail Size | 4
7 | T-Slot Rail 1.5" x .8" | McMaster-Carr #47065T686 | 21.0" | 1
8 | T-Slot Rail Connector, 3-Way | McMaster-Carr #47065T245 | 1-1/2" Rail Size | 2
9 | T-Slot Rail Connector, Corner | McMaster-Carr #47065T243 | 1-1/2" Rail Size | 2
10 | Spring Nut Flanged Button Head | McMaster-Carr #3136N276 | 11/16" Length | 21
11 | Sliding Shelf Assembly | -- | -- | 1
12 | T-Slot Rail Slide 1.5" / 40mm | McMaster-Carr #5537T293 | -- | 2
13 | T-Slot Rail L-Shaped Connector | McMaster-Carr #5537T316 | 1-1/2" Size | 12
14 | T-Slot Rail 90° Bracket | McMaster-Carr #47065T845 | 1-1/2" Size | 2
15 | SS Button Cap Screw 5/16-18 | McMaster-Carr #92949A580 | 5/8" | 2

DRAWN | RM | 20 APR 2020 | TITLE: 2020-04-20 Cooling cart Asm
CHECKED

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

QTY: 1 | SCALE: 1:8 | SHEET 1 OF 1
