fuslab-uofu/SkinCoolingDevice/FinalProduct/AssemblyFiles_Cart/AssemblyDiagrams/2020-04-21_Membrane_Asm.PDF

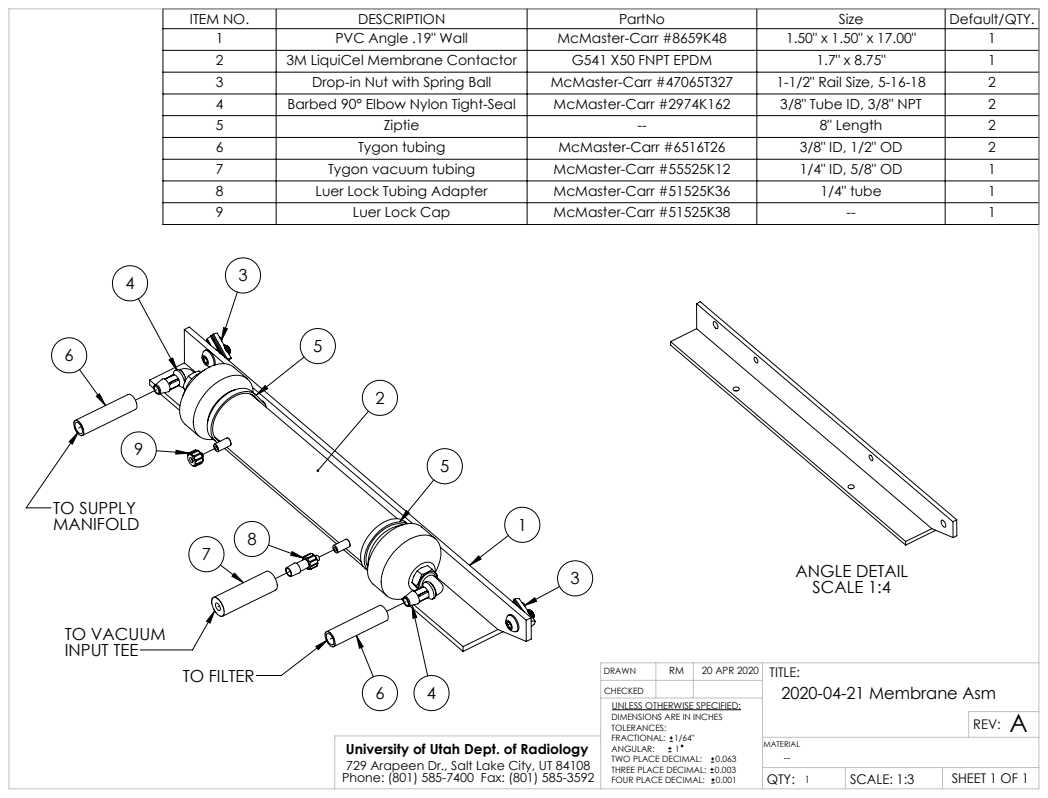
[picture p68: page 1]
TO FILTER; TO VACUUM INPUT TEE; TO SUPPLY; ANGLE DETAIL SCALE 1:4

ITEM NO. | DESCRIPTION | PartNo | Size | Default/QTY.
1 | PVC Angle .19" Wall | McMaster-Carr #8659K48 | 1.50" x 1.50" x 17.00" | 1
2 | 3M LiquiCel Membrane Contactor | G541 X50 FNPT EPDM | 1.7" x 8.75" | 1
3 | Drop-in Nut with Spring Ball | McMaster-Carr #47065T327 | 1-1/2" Rail Size, 5-16-18 | 2
4 | Barbed 90° Elbow Nylon Tight-Seal | McMaster-Carr #2974K162 | 3/8" Tube ID, 3/8" NPT | 2
5 | Ziptie | -- | 8" Length | 2
6 | Tygon tubing | McMaster-Carr #6516T26 | 3/8" ID, 1/2" OD | 2
7 | Tygon vacuum tubing | McMaster-Carr #55525K12 | 1/4" ID, 5/8" OD | 1
8 | Luer Lock Tubing Adapter | McMaster-Carr #51525K36 | 1/4" tube | 1
9 | Luer Lock Cap | McMaster-Carr #51525K38 | -- | 1

DRAWN | RM | 20 APR 2020 | TITLE: 2020-04-21 Membrane Asm
CHECKED

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

QTY: 1 | SCALE: 1:3 | SHEET 1 OF 1
