fuslab-uofu/SkinCoolingDevice/FinalProduct/AssemblyFiles_Cart/AssemblyDiagrams/2020-04-21_Muffler_Asm.PDF

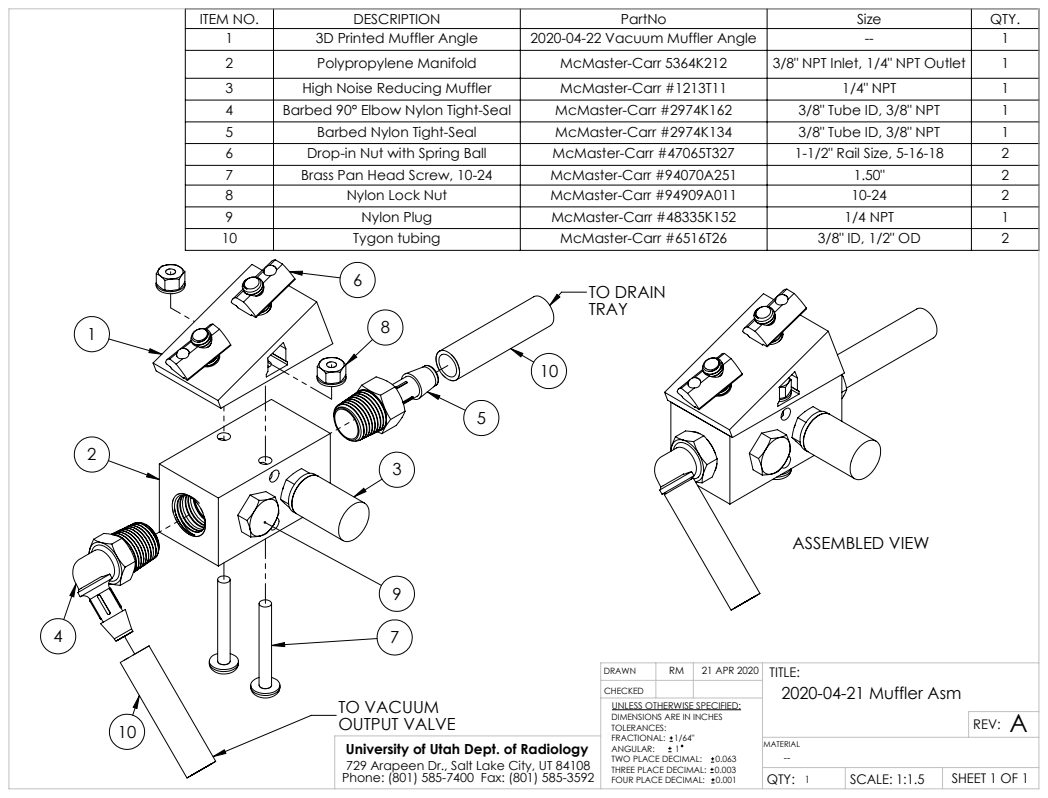
[picture p69: page 1]
TO VACUUM OUTPUT VALVE; TO DRAIN; ASSEMBLED VIEW

ITEM NO. | DESCRIPTION | PartNo | Size | QTY.
1 | 3D Printed Muffler Angle | 2020-04-22 Vacuum Muffler Angle | -- | 1
2 | Polypropylene Manifold | McMaster-Carr 5364K212 | 3/8" NPT Inlet, 1/4" NPT Outlet | 1
3 | High Noise Reducing Muffler | McMaster-Carr #1213T11 | 1/4" NPT | 1
4 | Barbed 90° Elbow Nylon Tight-Seal | McMaster-Carr #2974K162 | 3/8" Tube ID, 3/8" NPT | 1
5 | Barbed Nylon Tight-Seal | McMaster-Carr #2974K134 | 3/8" Tube ID, 3/8" NPT | 1
6 | Drop-in Nut with Spring Ball | McMaster-Carr #47065T327 | 1-1/2" Rail Size, 5-16-18 | 2
7 | Brass Pan Head Screw, 10-24 | McMaster-Carr #94070A251 | 1.50" | 2
8 | Nylon Lock Nut | McMaster-Carr #94909A011 | 10-24 | 2
9 | Nylon Plug | McMaster-Carr #48335K152 | 1/4 NPT | 1
10 | Tygon tubing | McMaster-Carr #6516T26 | 3/8" ID, 1/2" OD | 2

DRAWN | RM | 21 APR 2020 | TITLE: 2020-04-21 Muffler Asm
CHECKED

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

QTY: 1 | SCALE: 1:1.5 | SHEET 1 OF 1
