fuslab-uofu/SkinCoolingDevice/FinalProduct/AssemblyFiles_Cart/AssemblyDiagrams/2020-04-22_Chiller_Asm.PDF

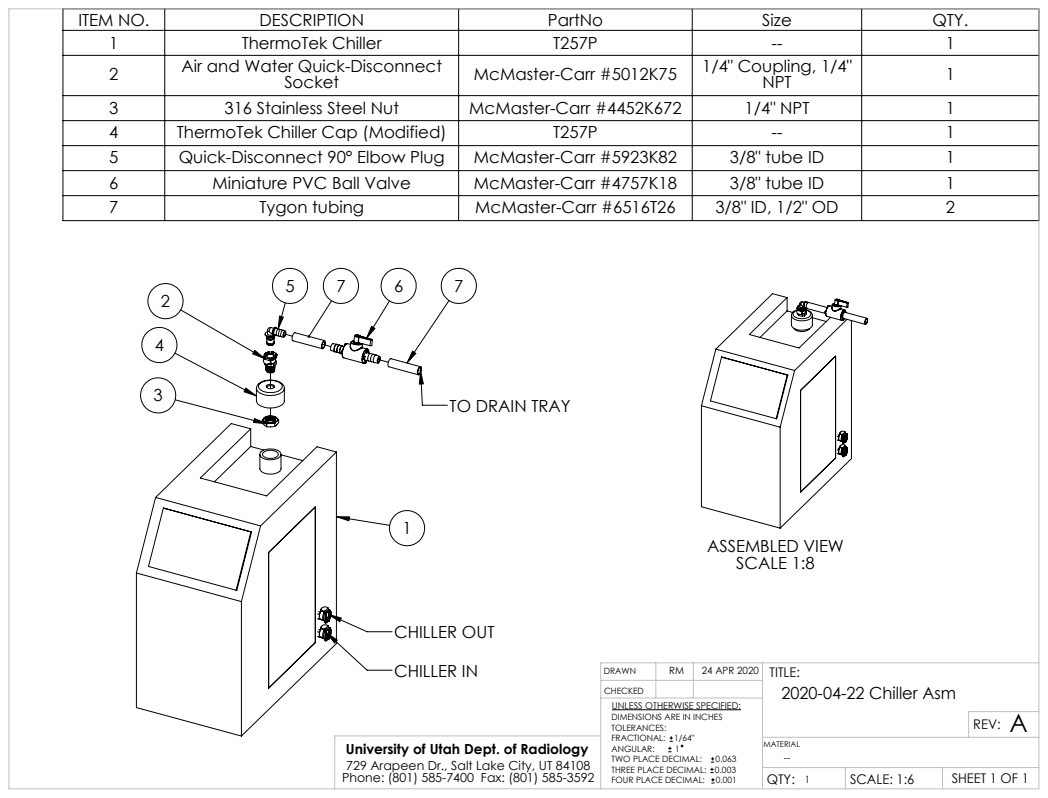
[picture p70: page 1]
CHILLER OUT; CHILLER IN; ASSEMBLED VIEW SCALE 1:8

ITEM NO. | DESCRIPTION | PartNo | Size | QTY.
1 | ThermoTek Chiller | T257P | -- | 1
2 | Air and Water Quick-Disconnect Socket | McMaster-Carr #5012K75 | 1/4" Coupling, 1/4" NPT | 1
3 | 316 Stainless Steel Nut | McMaster-Carr #4452K672 | 1/4" NPT | 1
4 | ThermoTek Chiller Cap (Modified) | T257P | -- | 1
5 | Quick-Disconnect 90° Elbow Plug | McMaster-Carr #5923K82 | 3/8" tube ID | 1
6 | Miniature PVC Ball Valve | McMaster-Carr #4757K18 | 3/8" tube ID | 1
7 | Tygon tubing | McMaster-Carr #6516T26 | 3/8" ID, 1/2" OD | 2

TO DRAIN TRAY

DRAWN | RM | 24 APR 2020 | TITLE: 2020-04-22 Chiller Asm
CHECKED

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

QTY: 1 | SCALE: 1:6 | SHEET 1 OF 1
