fuslab-uofu/SkinCoolingDevice/FinalProduct/AssemblyFiles_Cart/AssemblyDiagrams/2020-04-22_Pressure_gauge_Asm.PDF

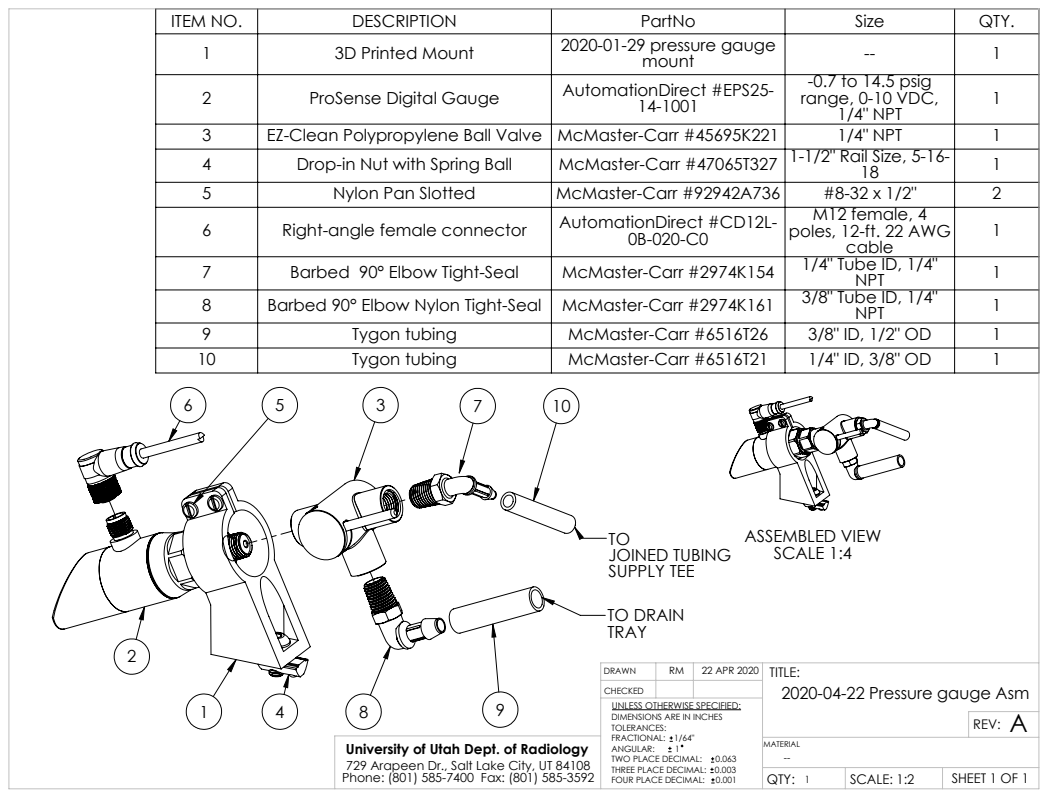
[picture p72: page 1]
JOINED TUBING SUPPLY TEE; TO DRAIN; ASSEMBLED VIEW SCALE 1:4

ITEM NO. | DESCRIPTION | PartNo | Size | QTY.
1 | 3D Printed Mount | 2020-01-29 pressure gauge mount | -- | 1
2 | ProSense Digital Gauge | AutomationDirect #EPS25-14-1001 | -0.7 to 14.5 psig range, 0-10 VDC, 1/4" NPT | 1

3 | EZ-Clean Polypropylene Ball Valve | McMaster-Carr #45695K221 | 1/4" NPT | 1
4 | Drop-in Nut with Spring Ball | McMaster-Carr #47065T327 | 1-1/2" Rail Size, 5-16-18 | 1
5 | Nylon Pan Slotted | McMaster-Carr #92942A736 | #8-32 x 1/2" | 2
6 | Right-angle female connector | AutomationDirect #CD12L-0B-020-C0 | M12 female, 4 poles, 12-ft. 22 AWG cable | 1

7 | Barbed 90° Elbow Tight-Seal | McMaster-Carr #2974K154 | 1/4" Tube ID, 1/4" NPT | 1
8 | Barbed 90° Elbow Nylon Tight-Seal | McMaster-Carr #2974K161 | 3/8" Tube ID, 1/4" NPT | 1
9 | Tygon tubing | McMaster-Carr #6516T26 | 3/8" ID, 1/2" OD | 1
10 | Tygon tubing | McMaster-Carr #6516T21 | 1/4" ID, 3/8" OD | 1

DRAWN | RM | 22 APR 2020 | TITLE: 2020-04-22 Pressure gauge Asm
CHECKED

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

QTY: 1 | SCALE: 1:2 | SHEET 1 OF 1
