fuslab-uofu/SkinCoolingDevice/FinalProduct/AssemblyFiles_Cart/AssemblyDiagrams/2020-04-23_Joined_tubing_clamp_Asm.PDF

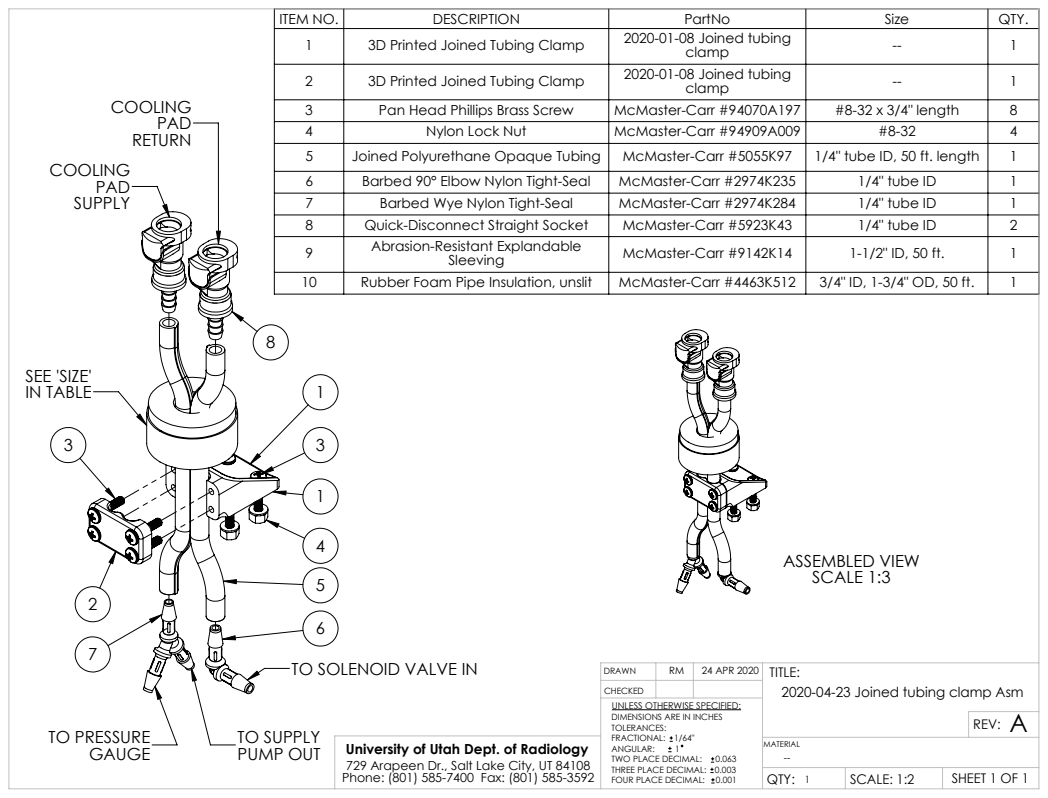
[picture p73: page 1]
TO SOLENOID VALVE IN; TO PRESSURE; TO SUPPLY PUMP OUT; SEE 'SIZE' IN TABLE; ASSEMBLED VIEW SCALE 1:3

ITEM NO. | DESCRIPTION | PartNo | Size | QTY.
1 | 3D Printed Joined Tubing Clamp | 2020-01-08 Joined tubing clamp | -- | 1

2 | 3D Printed Joined Tubing Clamp | 2020-01-08 Joined tubing clamp | -- | 1

3 | Pan Head Phillips Brass Screw | McMaster-Carr #94070A197 | #8-32 x 3/4" length | 8
4 | Nylon Lock Nut | McMaster-Carr #94909A009 | #8-32 | 4
5 | Joined Polyurethane Opaque Tubing | McMaster-Carr #5055K97 | 1/4" tube ID, 50 ft. length | 1
6 | Barbed 90° Elbow Nylon Tight-Seal | McMaster-Carr #2974K235 | 1/4" tube ID | 1
7 | Barbed Wye Nylon Tight-Seal | McMaster-Carr #2974K284 | 1/4" tube ID | 1
8 | Quick-Disconnect Straight Socket | McMaster-Carr #5923K43 | 1/4" tube ID | 2
9 | Abrasion-Resistant Explandable Sleeving | McMaster-Carr #9142K14 | 1-1/2" ID, 50 ft. | 1

10 | Rubber Foam Pipe Insulation, unslit | McMaster-Carr #4463K512 | 3/4" ID, 1-3/4" OD, 50 ft. | 1

DRAWN | RM | 24 APR 2020 | TITLE: 2020-04-23 Joined tubing clamp Asm
CHECKED

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

QTY: 1 | SCALE: 1:2 | SHEET 1 OF 1
