fuslab-uofu/SkinCoolingDevice/FinalProduct/AssemblyFiles_Cart/AssemblyDiagrams/2020-04-23_Line_purge_Asm.PDF

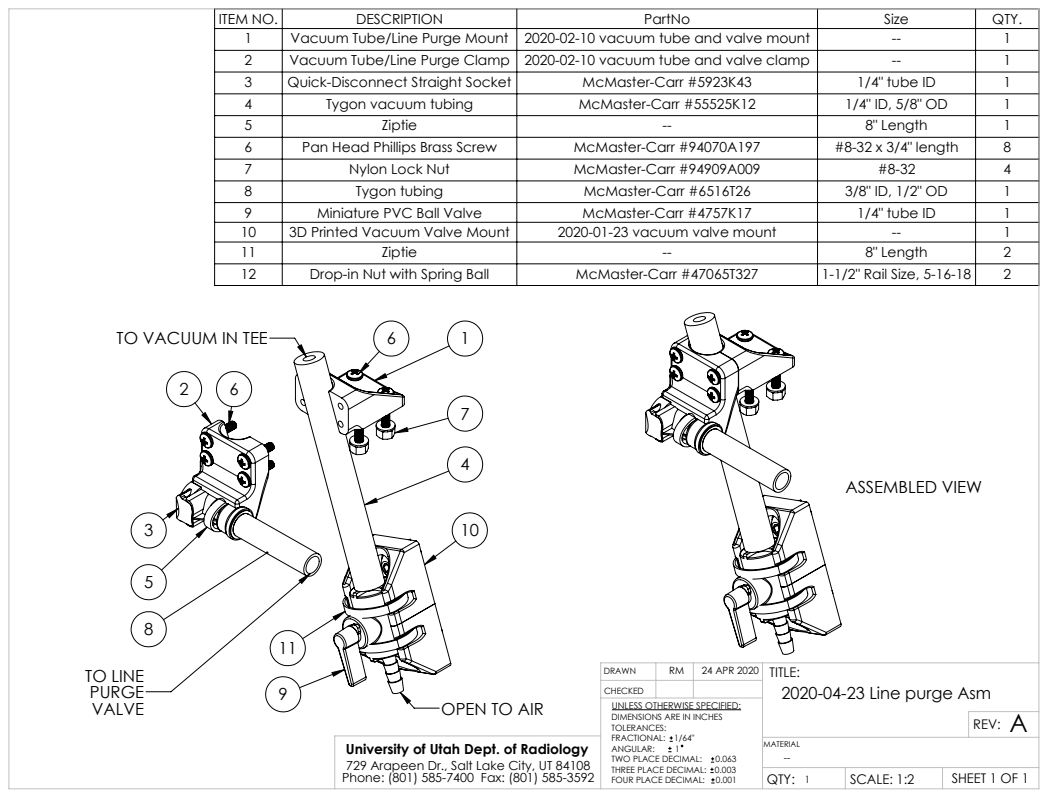
[picture p74: page 1]
TO LINE; ASSEMBLED VIEW

ITEM NO. | DESCRIPTION | PartNo | Size | QTY.
1 | Vacuum Tube/Line Purge Mount | 2020-02-10 vacuum tube and valve mount | -- | 1
2 | Vacuum Tube/Line Purge Clamp | 2020-02-10 vacuum tube and valve clamp | -- | 1
3 | Quick-Disconnect Straight Socket | McMaster-Carr #5923K43 | 1/4" tube ID | 1
4 | Tygon vacuum tubing | McMaster-Carr #55525K12 | 1/4" ID, 5/8" OD | 1
5 | Ziptie | -- | 8" Length | 1
6 | Pan Head Phillips Brass Screw | McMaster-Carr #94070A197 | #8-32 x 3/4" length | 8
7 | Nylon Lock Nut | McMaster-Carr #94909A009 | #8-32 | 4
8 | Tygon tubing | McMaster-Carr #6516T26 | 3/8" ID, 1/2" OD | 1
9 | Miniature PVC Ball Valve | McMaster-Carr #4757K17 | 1/4" tube ID | 1
10 | 3D Printed Vacuum Valve Mount | 2020-01-23 vacuum valve mount | -- | 1
11 | Ziptie | -- | 8" Length | 2
12 | Drop-in Nut with Spring Ball | McMaster-Carr #47065T327 | 1-1/2" Rail Size, 5-16-18 | 2

TO VACUUM IN TEE

DRAWN | RM | 24 APR 2020 | TITLE: 2020-04-23 Line purge Asm
CHECKED

OPEN TO AIR

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

QTY: 1 | SCALE: 1:2 | SHEET 1 OF 1
