fuslab-uofu/SkinCoolingDevice/FinalProduct/AssemblyFiles_Cart/AssemblyDiagrams/2020-07-16_Cooling_Pad_Asm.PDF

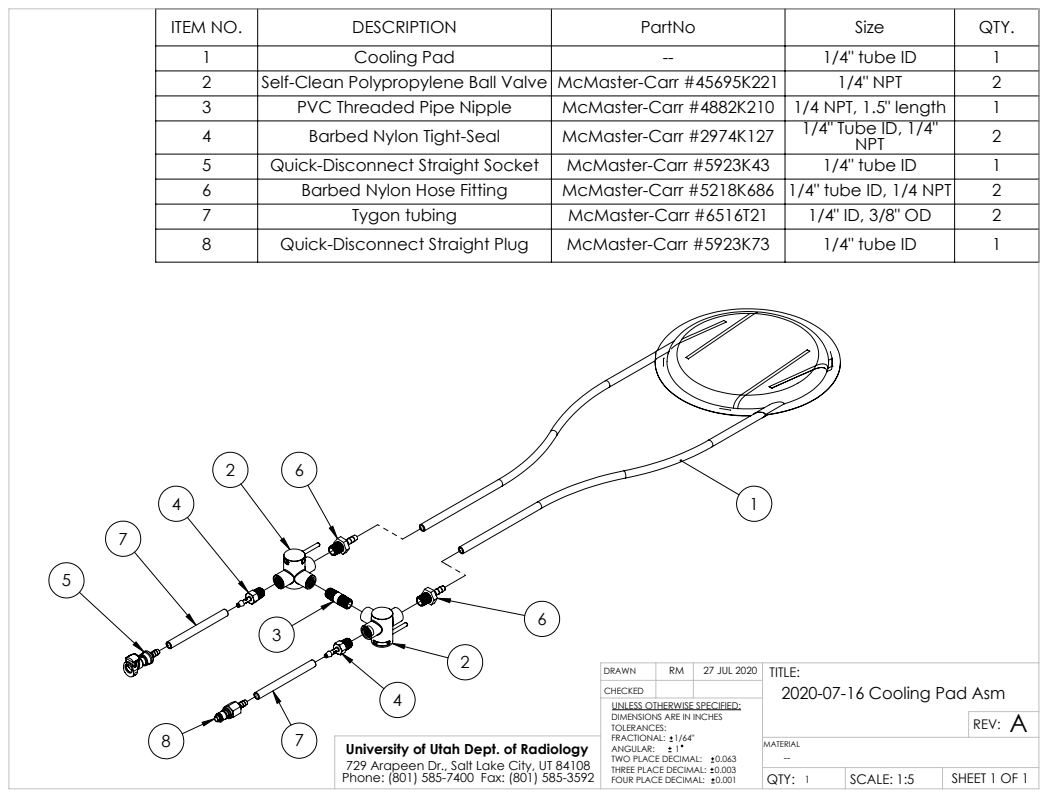
[picture p75: page 1]

ITEM NO. | DESCRIPTION | PartNo | Size | QTY.
1 | Cooling Pad | -- | 1/4" tube ID | 1
2 | Self-Clean Polypropylene Ball Valve | McMaster-Carr #45695K221 | 1/4" NPT | 2
3 | PVC Threaded Pipe Nipple | McMaster-Carr #4882K210 | 1/4 NPT, 1.5" length | 1
4 | Barbed Nylon Tight-Seal | McMaster-Carr #2974K127 | 1/4" Tube ID, 1/4" NPT | 2
5 | Quick-Disconnect Straight Socket | McMaster-Carr #5923K43 | 1/4" tube ID | 1
6 | Barbed Nylon Hose Fitting | McMaster-Carr #5218K686 | 1/4" tube ID, 1/4 NPT | 2
7 | Tygon tubing | McMaster-Carr #6516T21 | 1/4" ID, 3/8" OD | 2
8 | Quick-Disconnect Straight Plug | McMaster-Carr #5923K73 | 1/4" tube ID | 1

DRAWN | RM | 27 JUL 2020 | TITLE: 2020-07-16 Cooling Pad Asm
CHECKED

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

QTY: 1 | SCALE: 1:5 | SHEET 1 OF 1
