fuslab-uofu/SkinCoolingDevice/FinalProduct/AssemblyFiles_Pad/Baffles Template.PDF

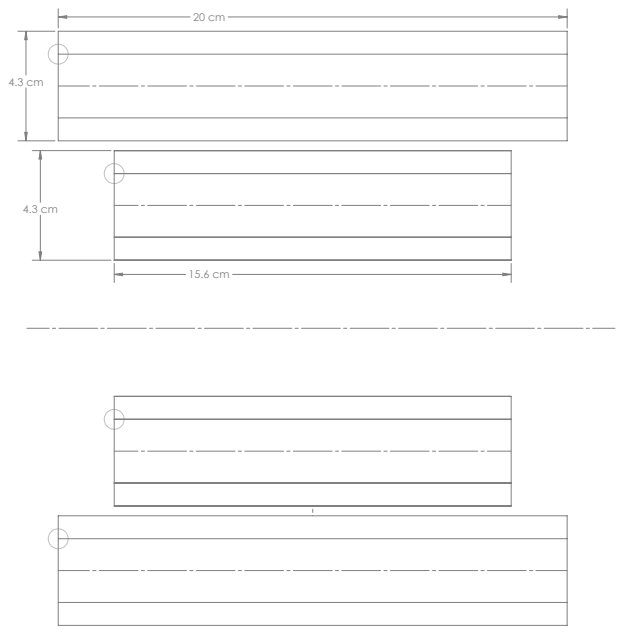
[picture p77: page 1]
