fuslab-uofu/SkinCoolingDevice/FinalProduct/AssemblyFiles_Pad/Bottom Template.PDF

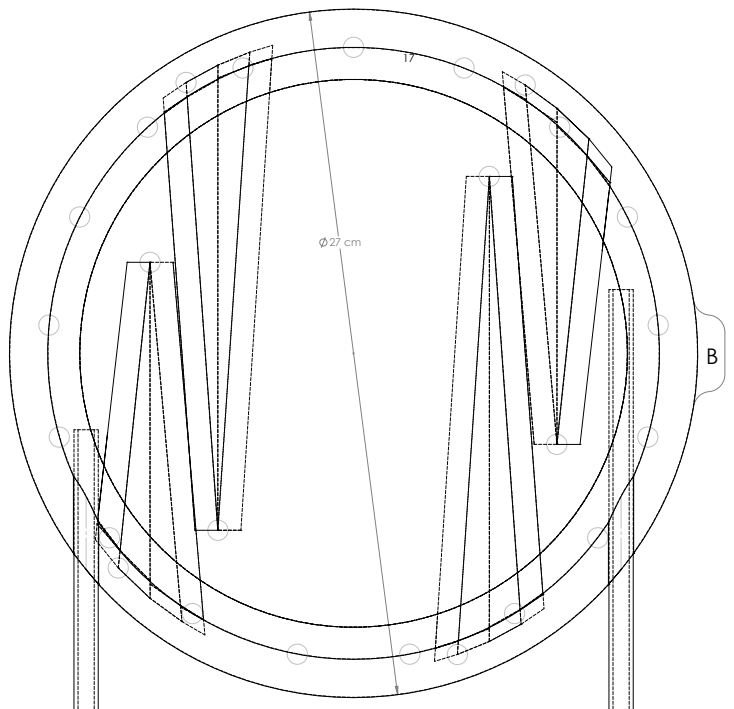
[picture p78: page 1]
