fuslab-uofu/SkinCoolingDevice/FinalProduct/AssemblyFiles_Pad/Top Template.PDF

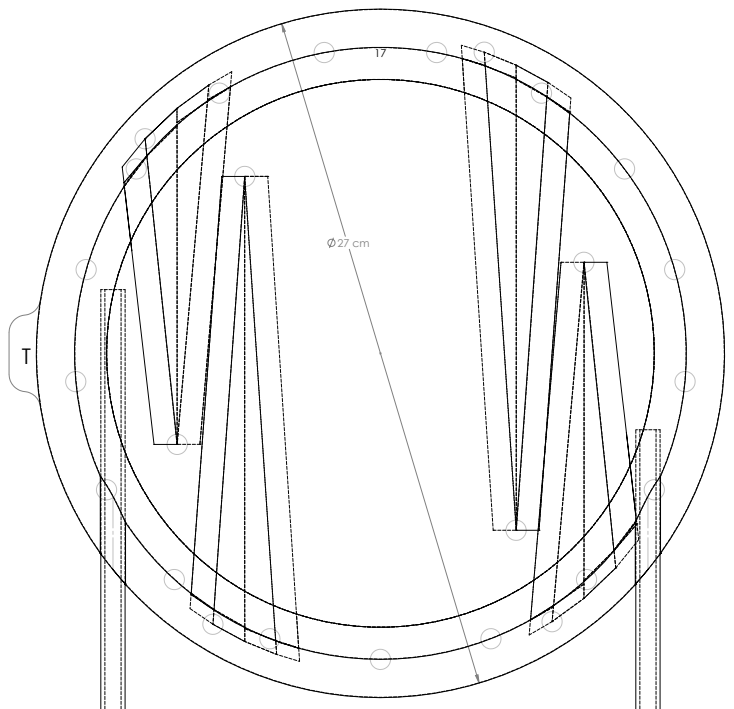
[picture p79: page 1]
