fuslab-uofu/SkinCoolingDevice/(commit log)

2020-09-25 Files updated for new vacuum pump, oxygen probe and user manual
    [2020-08-10_Large_pad_-_template.DXF, 2020-08-10_Large_pad_-_template.SLDDRW, 2020-08-10_Larger_Pad.SLDPRT, 2020-08-10_Pad_-_larger_size.SLDPRT]
2021-02-17 Added new Pad construction instructions and added beta versions of the control box wiring and plumbing diagrams.
